stefan-schweiger/VdMot_Controller/hardware/case/vdmot_case_fitcheck.stl

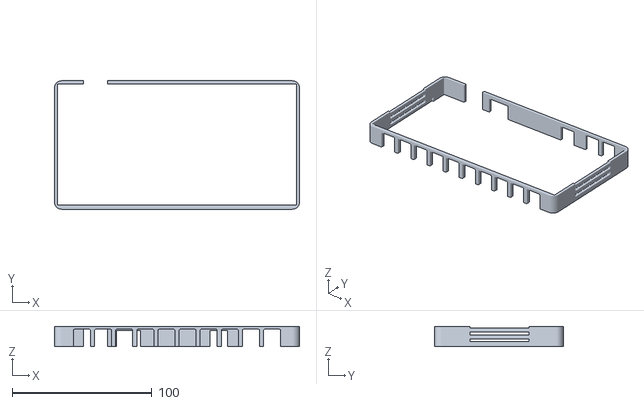
[picture p6: CAD file, 2026-10-22]
hardware/case/vdmot_case_fitcheck.stl
175.4 x 92.0 x 14.5
