stefan-schweiger/VdMot_Controller/hardware/case/vdmot_case_lid.stl

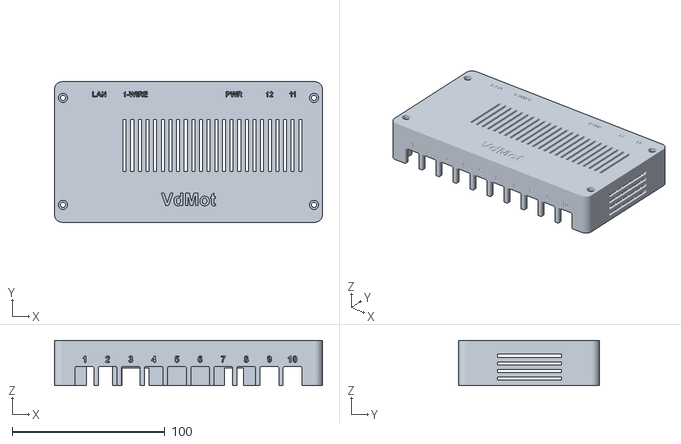
[picture p7: CAD file, 2026-10-22]
hardware/case/vdmot_case_lid.stl
175.4 x 92.0 x 29.5
