stefan-schweiger/VdMot_Controller/hardware/case/vdmot_case.step

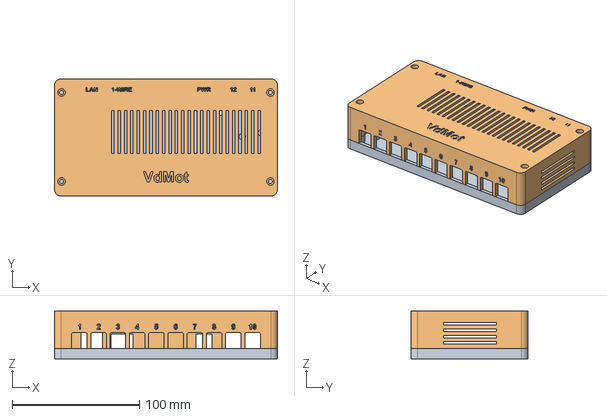
[picture p8: CAD file, 2026-10-22]
hardware/case/vdmot_case.step
175.4 x 92.0 x 37.6 mm
