stefan-schweiger/VdMot_Controller/hardware/case/vdmot_case_base.stl

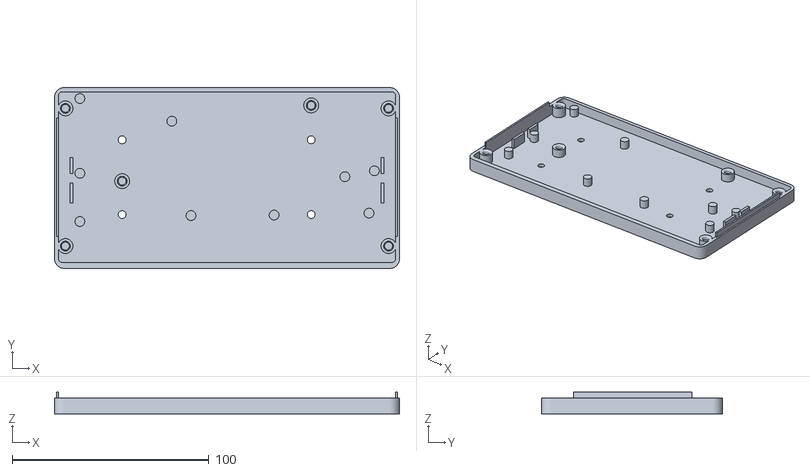
[picture p9: CAD file, 2026-10-22]
hardware/case/vdmot_case_base.stl
175.4 x 92.0 x 11.1
