stefan-schweiger/VdMot_Controller/software_esp32/src/main.cpp

/**HEADER*******************************************************************
  project : VdMot Controller

  author : SurfGargano, Lenti84

  Comments:

  Version :

  Modifcations :


***************************************************************************
*
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
  Copyright (C) 2021 Lenti84  https://github.com/Lenti84/VdMot_Controller

*END************************************************************************/


#include "globals.h"

#include "VdmConfig.h"
#include "VdmSystem.h"
#include "VdmNet.h"
#include "VdmTask.h"
#include "stm32.h"
#include "esp_task_wdt.h"
#include "esp_err.h"
#include "Messenger.h"
#include "VdmTask.h"
#include "RtcRam.h"
#include "PanicRecord.h"
#include "stmApp.h"

uint32_t * StackPtrAtStart;
uint32_t * StackPtrEnd;
UBaseType_t watermarkStart;
uint32_t stackSize;



void setup(void) {
  disableCore0WDT();
  disableCore1WDT();
  disableLoopWDT(); 

  UART_DBG.begin(115200);

  uint32_t* SpStart = NULL;
  StackPtrAtStart = (uint32_t *)&SpStart;
  watermarkStart =  uxTaskGetStackHighWaterMark(NULL);
  StackPtrEnd = StackPtrAtStart - watermarkStart;
  stackSize = StackPtrAtStart - StackPtrEnd;

  #ifdef EnvDevelop
    UART_DBG.println("VdMot_Controller");
    UART_DBG.printf("\r\n\r\nAddress of Stackpointer near start is:  %p \r\n",  (uint32_t *)StackPtrAtStart);
    UART_DBG.printf("End of Stack is near: %p \r\n",  (uint32_t *)StackPtrEnd);
    UART_DBG.printf("Free Stack near start is:  %d \r\n",  (uint32_t)StackPtrAtStart - (uint32_t)StackPtrEnd);
    UART_DBG.printf("Free Prefs entries  %d \r\n",  VdmConfig.prefs.freeEntries());
    UART_DBG.printf("Config space  %d bytes (max 20k) \r\n",  sizeof(VdmConfig.configFlash));
    UART_DBG.println("readingCnt read at Start "+String(readingCnt));
  #endif
  readingCnt = 123;

  UART_DBG.println("readingCnt read "+String(readingCnt));
  Stm32.STM32ota_setup();
  esp_reset_reason_t rr=esp_reset_reason();
  VdmSystem.panicInfo=takePanicRecord();
  if (VdmSystem.panicInfo.length()>0) UART_DBG.println("Crash before this start: "+VdmSystem.panicInfo);
  // a restart for new network settings or an ESP32 update keeps the STM32 running, so the valves keep
  // their positions and learned strokes, the ESP32 takes over its targets (StmApp.app_setup)
  // every other start resets the STM32 as before (except power on, it starts with the ESP32): a crash
  // or watchdog of the ESP32 may have left it in an unknown state, and "Reboot" restarts everything
  StmApp.keptRunning=(rr==ESP_RST_SW) && (keepStmRunning==KEEP_STM_RUNNING);
  keepStmRunning=0;
  if ((rr!=ESP_RST_POWERON) && !StmApp.keptRunning) {
    Stm32.ResetSTM32(false);
  }
  #ifdef EnvDevelop
    UART_DBG.println("Start Config");
  #endif
  // init config, read from flash, init network
  VdmSystem.stackSize = stackSize;
  VdmConfig.init();
  VdmConfig.checkToResetCfg();
  VdmNet.init();
  VdmTask.init();
  VdmSystem.getFSDirectory(); 
}

void loop(void) {
  taskManager.runLoop(); 
}
