stefan-schweiger/VdMot_Controller/software_esp32/include/VdmConfig.h

/**HEADER*******************************************************************
  project : VdMot Controller

  author : SurfGargano, Lenti84

  Comments:

  Version :

  Modifcations :


***************************************************************************
*
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
  Copyright (C) 2021 Lenti84  https://github.com/Lenti84/VdMot_Controller

*END************************************************************************/



#pragma once

#include "globals.h"
#include <Preferences.h>
#include <ArduinoJson.h>

#define pinSetFactoryCfg  2

enum protType  {protTypeNone=0,protTypeMqtt=1,protTypeMqttHA=2};

#define allowHeatingCooling 0
#define allowHeating 1
#define allowCooling 2

enum numFormat {numFormatIntl=0,numFormatGer=1};

typedef struct {
  uint8_t eth_wifi;
  bool dhcpEnabled;
  uint32_t staticIp;
  uint32_t mask;
  uint32_t gateway;
  uint32_t dnsIp;          
  char ssid[65];
  char pwd[65];
  char userName[65];
  char userPwd[65];
  char timeServer[65];
  long timeOffset;
  int daylightOffset; 
  uint8_t syslogLevel;
  uint32_t syslogIp;
  uint32_t syslogPort;
} VDM_NETWORK_CONFIG;

typedef struct {
  char tz[50];
  char tzCode[50];
} VDM_SYSTEM_TIME_ZONE_CONFIG;


typedef struct {
  uint8_t celsiusFahrenheit;
  char stationName[21];
} VDM_SYSTEM_CONFIG;

typedef struct  {
  uint8_t publishSeparate : 1 ;
  uint8_t publishAllTemps : 1;
  uint8_t publishPathAsRoot : 1 ;
  uint8_t publishUpTime : 1;
  uint8_t publishOnChange : 1;
  uint8_t publishRetained : 1;
  uint8_t publishPlainText : 1;
  uint8_t publishDiag : 1;
} VDM_PROTOCOL_CONFIG_FLAGS;

typedef struct  {
  uint8_t timeoutTSActive : 1 ;
  uint8_t timeoutDSActive : 1 ;
  uint8_t numFormat : 1 ;
} VDM_PROTOCOL_MQTT_CONFIG_FLAGS;


typedef struct  {
  VDM_PROTOCOL_MQTT_CONFIG_FLAGS flags;
  uint32_t timeOut;
  uint8_t toPos;
} VDM_PROTOCOL_MQTT_CONFIG;


typedef struct {
  uint8_t  dataProtocol; // 0 = no protocol , 1 = mqtt, 2 = mqtt HA
  uint32_t brokerIp;
  uint16_t brokerPort;
  uint32_t brokerInterval;
  uint32_t publishInterval;
  char userName[65];
  char userPwd[65];
  VDM_PROTOCOL_CONFIG_FLAGS protocolFlags;
  uint16_t keepAliveTime;
  uint32_t minBrokerDelay;
  VDM_PROTOCOL_MQTT_CONFIG mqttConfig;
} VDM_PROTOCOL_CONFIG;



// names of valves and sensors, they are part of the MQTT topics (10 characters until 1a222a0)
#define NAME_LEN                    30

typedef struct {
  char  name[NAME_LEN+1];
  bool active;
} VDM_VALVE_CONFIG;

typedef struct {
  VDM_VALVE_CONFIG valveConfig[ACTUATOR_COUNT];
  uint8_t dayOfCalib;
  uint8_t hourOfCalib;
} VDM_VALVES_CONFIG;

typedef struct  {
  uint8_t active : 1 ;
  uint8_t allow : 3;
  uint8_t windowInstalled : 1;
} VDM_VALVE_CONTROL_CONFIG_FLAGS;


typedef struct {
  VDM_VALVE_CONTROL_CONFIG_FLAGS controlFlags;
  uint8_t link;
  uint8_t valueSource;
  uint8_t targetSource;
  uint16_t xp;
  int8_t offset;
  uint16_t ti;
  uint16_t ts;
  float ki;
  uint8_t scheme;
  uint8_t startActiveZone;                // not used any more (the valve range does it), kept for the stored layout
  uint8_t endActiveZone;
} VDM_VALVE_CONTROL_CONFIG;

typedef struct {
  float tTarget;
} VDM_VALVE_CONTROL_INIT;

typedef struct {
  float alpha;
  float beta;
  float deadband;
} VDM_VALVE_CONTROL1_CONFIG;

typedef struct {
  VDM_VALVE_CONTROL_CONFIG valveControlConfig[ACTUATOR_COUNT];
  uint8_t heatControl;
  uint8_t parkingPosition;
} VDM_VALVES_CONTROL_CONFIG;

typedef struct {
  VDM_VALVE_CONTROL1_CONFIG valveControl1Config[ACTUATOR_COUNT];
} VDM_VALVES_CONTROL1_CONFIG;

typedef struct {
  VDM_VALVE_CONTROL_INIT valveControlInit[ACTUATOR_COUNT];
} VDM_VALVES_CONTROL_INIT;

// valve range, every target is mapped to it, each array stored with its own nvs key so the layout
// of the other valve control blobs stays unchanged
typedef struct {
  uint8_t rangeFrom[ACTUATOR_COUNT];      // smallest opening in % when the valve is open, 0..99, default 0
  uint8_t rangeTo[ACTUATOR_COUNT];        // opening in % for a target of 100 % (hydraulic balancing), 1..100, default 100
  uint8_t rangeCanClose[ACTUATOR_COUNT];  // 1: the valve can close (scaled: at 0 %, direct: below from), 0: it stays at rangeFrom, default 1
  uint8_t rangeMode[ACTUATOR_COUNT];      // rangeScaled (default) or rangeDirect
} VDM_VALVES_RANGE_CONFIG;

// scaled: the target 1..100 % is spread over from..to; direct: the target is the opening, cut at from and to
#define rangeScaled                 0
#define rangeDirect                 1
// direct with "can close": closes below from minus this, opens again at from
#define RANGE_HYSTERESIS            5

// what a valve does while its window is open and how long its controller ignores the room temperature after
// the window closed (minutes), with the values for all zones; stored with its own nvs key
typedef struct {
  uint8_t mode[ACTUATOR_COUNT];           // windowModeClose (default) or windowModeKeep
  uint8_t hold[ACTUATOR_COUNT];           // 0 = continue at once (default)
  uint8_t defaultMode;
  uint8_t defaultHold;
} VDM_VALVES_WINDOW_CONFIG;

// close: the valve goes to .../window/target (default 0 %); keep: it stays where it is
#define windowModeClose             0
#define windowModeKeep              1

// controller settings a zone takes from the settings for all zones unless it sets them itself,
// bit n of VDM_VALVES_CONTROL_SHARED.own is setting n, the names are the json keys (ctrlFieldNames)
enum {
  ctrlFieldValueSource, ctrlFieldTargetSource, ctrlFieldInitTarget, ctrlFieldXp, ctrlFieldTi, ctrlFieldWindow, ctrlFieldAllow,
  ctrlFieldTs, ctrlFieldDeadband, ctrlFieldOffset, ctrlFieldScheme, ctrlFieldKi, ctrlFieldWindowMode, ctrlFieldWindowHold,
  CTRL_FIELD_COUNT
};
extern const char* const ctrlFieldNames[CTRL_FIELD_COUNT];

typedef struct {
  VDM_VALVE_CONTROL_CONFIG control;       // active and link are not used
  float tTarget;
  float deadband;
} VDM_VALVE_CONTROL_DEFAULTS;

// stored with their own nvs keys, so the layout of the other valve control blobs stays unchanged
typedef struct {
  VDM_VALVE_CONTROL_DEFAULTS defaults;    // the settings for all zones
  uint16_t own[ACTUATOR_COUNT];           // the settings each zone sets itself
} VDM_VALVES_CONTROL_SHARED;


typedef struct {
  char name[NAME_LEN+1];
  bool active;
  int offset;
  char ID[25];
} VDM_TEMP_CONFIG;

typedef struct {
  VDM_TEMP_CONFIG tempConfig[TEMP_SENSORS_COUNT];
} VDM_TEMPS_CONFIG;

typedef struct {
  char name[NAME_LEN+1];
  bool active;
  float offset;
  float factor;
  char unit[9];
  char ID[25];
} VDM_VOLT_CONFIG;

typedef struct {
  uint8_t avType;
  uint16_t noOfAv;
} VDM_VOLT_AV_CONFIG;

typedef struct {
  VDM_VOLT_CONFIG voltConfig[VOLT_SENSORS_COUNT];
  VDM_VOLT_AV_CONFIG voltAVConfig[VOLT_SENSORS_COUNT];
} VDM_VOLTS_CONFIG;

// stored layout with names of 10 characters (until 1a222a0): taken over once at the start, and still written
// with shortened names, so an older firmware finds its settings
#define NAME_LEN_V1                 10

typedef struct {
  char name[NAME_LEN_V1+1];
  bool active;
} VDM_VALVE_CONFIG_V1;

typedef struct {
  char name[NAME_LEN_V1+1];
  bool active;
  int offset;
  char ID[25];
} VDM_TEMP_CONFIG_V1;

typedef struct {
  char name[NAME_LEN_V1+1];
  bool active;
  float offset;
  float factor;
  char unit[9];
  char ID[25];
} VDM_VOLT_CONFIG_V1;

typedef struct {
  VDM_VOLT_CONFIG_V1 voltConfig[VOLT_SENSORS_COUNT];
  VDM_VOLT_AV_CONFIG voltAVConfig[VOLT_SENSORS_COUNT];
} VDM_VOLTS_CONFIG_V1;

typedef struct  {
  uint8_t pushOver : 1 ;
  uint8_t email : 1 ;
} VDM_MSG_ACTIVE_CONFIG_FLAGS;

typedef struct  {
  uint8_t valveFailed : 1 ;
  uint8_t notDetect : 1;
  uint8_t mqttTimeOut : 1;
  uint8_t reset : 1;
  uint8_t ds18Failed : 1;
  uint8_t tValueFailed : 1;
  uint8_t valveBlocked : 1;
} VDM_MSG_REASON_CONFIG_FLAGS;

typedef struct  {
  VDM_MSG_REASON_CONFIG_FLAGS reasonFlags;
  uint16_t mqttTimeOutTime;
} VDM_MSG_REASON_CONFIG;

typedef struct {
  // pushover
  char userToken[31];
  char appToken[31];
  char title[31];
} VDM_MSG_PUSHOVER_CONFIG;

typedef struct {
  // email
  char user[65];
  char pwd[65];
  char host[65]; 
  uint16_t port;
  char recipient[65];
  char title[31];
} VDM_MSG_EMAIL_CONFIG;

typedef struct {
  VDM_MSG_ACTIVE_CONFIG_FLAGS activeFlags;
  VDM_MSG_REASON_CONFIG reason;
  VDM_MSG_PUSHOVER_CONFIG pushover;
  VDM_MSG_EMAIL_CONFIG email;
} VDM_MSG_CONFIG;

typedef struct 
{
  VDM_NETWORK_CONFIG netConfig;
  VDM_PROTOCOL_CONFIG protConfig;
  VDM_VALVES_CONFIG valvesConfig;
  VDM_TEMPS_CONFIG tempsConfig;
  VDM_VOLTS_CONFIG voltsConfig;
  VDM_SYSTEM_CONFIG systemConfig;
  VDM_VALVES_CONTROL_CONFIG valvesControlConfig;
  VDM_SYSTEM_TIME_ZONE_CONFIG timeZoneConfig;
  VDM_MSG_CONFIG messengerConfig;
  VDM_VALVES_CONTROL_INIT valvesControlInit;
  VDM_VALVES_CONTROL1_CONFIG valvesControl1Config;
  VDM_VALVES_RANGE_CONFIG valvesRangeConfig;
  VDM_VALVES_CONTROL_SHARED valvesControlShared;
  VDM_VALVES_WINDOW_CONFIG valvesWindowConfig;
} CONFIG_FLASH;

// settings as applied, a save applies only what has changed
typedef struct {
  VDM_NETWORK_CONFIG netConfig;
  VDM_PROTOCOL_CONFIG protConfig;
  VDM_SYSTEM_CONFIG systemConfig;
  VDM_SYSTEM_TIME_ZONE_CONFIG timeZoneConfig;
  VDM_VALVES_CONFIG valvesConfig;
} APPLIED_CONFIG;

typedef struct {
  time_t lastCalib; 
} MISC_VALUES;

typedef struct {
  uint8_t heatControl;
  uint8_t parkPosition; 
} HEATCFG_VALUES;

#define nvsNetCfg                   "netCfg"
#define nvsNetEthwifi               "ethwifi"
#define nvsNetDhcp                  "dhcp"
#define nvsNetStaticIp              "staticIp"
#define nvsNetMask                  "mask"
#define nvsNetGW                    "gw"
#define nvsNetDnsIp                 "dnsIp"       
#define nvsNetSsid                  "ssid"
#define nvsNetPwd                   "pwd"
#define nvsNetUserName              "userName"
#define nvsNetUserPwd               "userPwd"
#define nvsNetTimeServer            "timeServer"
#define nvsNetTimeOffset            "timeOffset"
#define nvsNetDayLightOffset        "dstOffset"
#define nvsNetSysLogEnable          "syslogEnable"
#define nvsNetSysLogIp              "sysLogIp"
#define nvsNetSysLogPort            "sysLogPort"

#define nvsTZCfg                    "tZCfg"
#define nvsTZ                       "tZ"
#define nvsTZCode                   "tZCode"

#define nvsProtCfg                  "protCfg"
#define nvsProtDataProt             "dataProt"
#define nvsProtBrokerIp             "brokerIp"
#define nvsProtBrokerPort           "brokerPort"
#define nvsProtBrokerInterval       "brokerInterval"
#define nvsProtPublishInterval      "publishInterval"
#define nvsProtBrokerUser           "brokerUser"
#define nvsProtBrokerPwd            "brokerPwd"
#define nvsProtBrokerPublishFlags   "brokerPF"
#define nvsProtBrokerKeepAliveTime  "brokerKAT"
#define nvsProtBrokerMinBrokerDelay "brokerMD"
#define nvsProtBrokerMQTTFlags      "brokerMQF"
#define nvsProtBrokerMQTTTimeOut    "brokerMQTO"
#define nvsProtBrokerMQTTToPos      "brokerMQToPos"

#define nvsValvesCfg                "valvesCfg"
#define nvsValvesControlCfg         "valvesCtrlCfg"
#define nvsValves                   "valves"
#define nvsValves2                  "valves2"       // with names of NAME_LEN characters
#define nvsValvesControl            "valvesCtrl"
#define nvsValvesControl1           "valvesCtrl1"
#define nvsValvesRangeFrom          "valvesCtrl2"   // held the minimum opening before, same meaning with "can close"
#define nvsValvesRangeTo            "valvesCtrl3"   // held the maximum opening before, same meaning
#define nvsValvesRangeCanClose      "valvesCtrl4"
#define nvsValvesControlDefaults    "valvesCtrl5"   // controller settings for all zones
#define nvsValvesControlOwn         "valvesCtrl6"   // the controller settings each zone sets itself
#define nvsValvesRangeMode          "valvesCtrl7"
#define nvsValvesWindow             "valvesCtrl8"
#define nvsValvesControlHeatControl "vCtrlHeat"
#define nvsValvesControlParkPos     "vCtrlParkPos"
#define nvsValvesControlInit        "vCtrlInit"

#define nvsTempsCfg                 "tempsCfg"
#define nvsTemps                    "temps"
#define nvsTemps2                   "temps2"

#define nvsVoltsCfg                 "voltsCfg"
#define nvsVolts                    "volts"
#define nvsVolts2                   "volts2"

#define nvsDayOfCalib               "dayOfCalib"
#define nvsHourOfCalib              "hourOfCalib"
#define nvsMovCalib                 "movCalib"

#define nvsMotorCfg                 "motorCfg"
#define nvsMotorMinC                "motorMinC"
#define nvsMotorMaxC                "motorMaxC"

#define nvsSystemCfg                "sysCfg"
#define nvsSystemCelsiusFahrenheit  "CF"
#define nvsSystemStationName        "stName"

#define nvsMsgCfg                   "msgCfg"
#define nvsMsgCfgFlags              "msgFlags"
#define nvsMsgCfgReason             "msgReas"
#define nvsMsgCfgMqttTimeout        "msgMQTO"
#define nvsMsgCfgPOAppToken         "POAppTk"
#define nvsMsgCfgPOUserToken        "POUserTk"
#define nvsMsgCfgPOTitle            "POTitle"

#define nvsMsgCfgEmailUser          "EUser"
#define nvsMsgCfgEmailPwd           "EPwd"
#define nvsMsgCfgEMailHost          "EHost"
#define nvsMsgCfgEmailPort          "EPort"
#define nvsMsgCfgEmailRecipient     "ERep"
#define nvsMsgCfgEmailTitle         "ETitle"

#define nvsMisc                     "Misc"
#define nvsMiscLastCalib            "MiscLC"

class CVdmConfig
{
public:
  CVdmConfig();
  void init();
  void setDefault();
  void clearConfig();
  void readConfig();
  void writeConfig(bool reboot=false);
  void saveConfig(bool restart);
  bool networkChanged();
  void resetConfig (bool reboot=false);
  void restoreConfig (bool reboot=false);
  void writeValvesControlConfig(bool reboot=false, bool restartTask=true);
  void writeSysLogValues();
  void postNetCfg (JsonObject doc);
  void postSysLogCfg (JsonObject doc);
  void postProtCfg (JsonObject doc);
  void postValvesCfg (JsonObject doc);
  void postValvesControlCfg (JsonObject doc);
  void postTempsCfg (JsonObject doc);
  void postVoltsCfg (JsonObject doc);
  void postSysCfg (JsonObject doc);
  void postMessengerCfg (JsonObject doc);
  String handleAuth (JsonObject doc);
  uint32_t doc2IPAddress(String id);
  void checkToResetCfg();
  void writeMiscValues();
  // controller settings for all zones, valve -1 = the settings for all zones
  double getCtrlField(int8_t valve, uint8_t field);
  void setCtrlField(int8_t valve, uint8_t field, double value);
  void deriveCtrlDefaults();
  void applyCtrlDefaults();
  uint16_t parseCtrlOwn(const char* names);
  String ctrlOwnNames(uint16_t own);

  Preferences prefs;

  CONFIG_FLASH configFlash;

  MISC_VALUES miscValues;
  HEATCFG_VALUES heatValues;
private:
  void applyConfig();
  void rememberApplied();
  VDM_NETWORK_CONFIG startNetConfig;    // the network is only set up at the start
  APPLIED_CONFIG appliedConfig;
};

extern CVdmConfig VdmConfig;
