stefan-schweiger/VdMot_Controller/software_esp32/src/VdmConfig.cpp

/**HEADER*******************************************************************
  project : VdMot Controller

  author : SurfGargano, Lenti84

  Comments:

  Version :

  Modifcations :


***************************************************************************
*
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
  Copyright (C) 2021 Lenti84  https://github.com/Lenti84/VdMot_Controller

*END************************************************************************/


#include <stdint.h>
#include "VdmConfig.h"
#include "VdmTask.h"
#include "web.h"
#include "Services.h"
#include "stmApp.h"
#include "PIControl.h"
#include "VdmNet.h"

CVdmConfig VdmConfig;

// copies a json string into a fixed size char array, the result is always null terminated
// values which are not a string (missing, null, numbers) are ignored
template <typename T>
static void copyJsonString(char* dest, size_t size, const T& value)
{
  const char* s = value.template as<const char*>();
  if (s != nullptr) strlcpy(dest, s, size);
}


CVdmConfig::CVdmConfig()
{
  
}

void CVdmConfig::init()
{
  setDefault();
  readConfig();
  startNetConfig=configFlash.netConfig;
  rememberApplied();
}

void CVdmConfig::resetConfig (bool reboot)
{  
  clearConfig(); 
  writeConfig();
  writeValvesControlConfig();
  if (reboot) Services.restartSystem(false);
}

void CVdmConfig::restoreConfig (bool reboot)
{  
  setDefault();
  writeConfig();
  writeValvesControlConfig();
  if (reboot) Services.restartSystem(false);
}

void CVdmConfig::setDefault()
{
  configFlash.netConfig.eth_wifi = 0;	      // 0 = auto (default)
  configFlash.netConfig.dhcpEnabled = 1;    // 0 = no DHCP, 1 = use DHCP
  configFlash.netConfig.staticIp = 0;
  configFlash.netConfig.mask = 0;
  configFlash.netConfig.gateway = 0;
  configFlash.netConfig.dnsIp = 0;
  memset (configFlash.netConfig.ssid,0,sizeof(configFlash.netConfig.ssid));
  memset (configFlash.netConfig.pwd,0,sizeof(configFlash.netConfig.pwd));
  memset (configFlash.netConfig.userName,0,sizeof(configFlash.netConfig.userName));
  memset (configFlash.netConfig.userPwd,0,sizeof(configFlash.netConfig.userPwd));
  memset (configFlash.timeZoneConfig.tz,0,sizeof(configFlash.timeZoneConfig.tz));
  memset (configFlash.timeZoneConfig.tzCode,0,sizeof(configFlash.timeZoneConfig.tzCode));
  clearConfig();
}

void CVdmConfig::clearConfig()
{ 
  configFlash.protConfig.dataProtocol = 0;
  configFlash.protConfig.brokerIp = 0;
  configFlash.protConfig.brokerPort = 0;
  configFlash.protConfig.brokerInterval = 1000;
  configFlash.protConfig.publishInterval = 10;
  configFlash.protConfig.minBrokerDelay = 5;
  memset (configFlash.protConfig.userName,0,sizeof(configFlash.protConfig.userName));
  memset (configFlash.protConfig.userPwd,0,sizeof(configFlash.protConfig.userPwd));
  configFlash.protConfig.protocolFlags.publishSeparate = false;
  configFlash.protConfig.protocolFlags.publishAllTemps = false;
  configFlash.protConfig.protocolFlags.publishPathAsRoot = false;
  configFlash.protConfig.protocolFlags.publishUpTime = false;
  configFlash.protConfig.protocolFlags.publishOnChange = false;
  configFlash.protConfig.protocolFlags.publishRetained = false;
  configFlash.protConfig.protocolFlags.publishPlainText = false;
  configFlash.protConfig.protocolFlags.publishDiag = false;
  configFlash.protConfig.keepAliveTime = 60;
  configFlash.protConfig.mqttConfig.flags.timeoutTSActive = false;
  configFlash.protConfig.mqttConfig.flags.timeoutDSActive = false;
  configFlash.protConfig.mqttConfig.timeOut = 120;
  configFlash.protConfig.mqttConfig.toPos = 10;
  
  for (uint8_t i=0; i<ACTUATOR_COUNT; i++) {
    configFlash.valvesConfig.valveConfig[i].active = false;
    memset (configFlash.valvesConfig.valveConfig[i].name,0,sizeof(configFlash.valvesConfig.valveConfig[i].name));
  }

  for (uint8_t i=0; i<ACTUATOR_COUNT; i++) {
    configFlash.valvesControlConfig.valveControlConfig[i].controlFlags.active = false;
    configFlash.valvesControlConfig.valveControlConfig[i].controlFlags.allow = allowHeatingCooling;
    configFlash.valvesControlConfig.valveControlConfig[i].controlFlags.windowInstalled = false;
    configFlash.valvesControlConfig.valveControlConfig[i].xp=20;
    configFlash.valvesControlConfig.valveControlConfig[i].link=0;
    configFlash.valvesControlConfig.valveControlConfig[i].offset=0;
    configFlash.valvesControlConfig.valveControlConfig[i].targetSource=0;
    configFlash.valvesControlConfig.valveControlConfig[i].valueSource=0;
    configFlash.valvesControlConfig.valveControlConfig[i].ti=3600;
    configFlash.valvesControlConfig.valveControlConfig[i].ts=900;
    configFlash.valvesControlConfig.valveControlConfig[i].scheme=0;
    configFlash.valvesControlConfig.valveControlConfig[i].ki=0.01;
    configFlash.valvesControlConfig.valveControlConfig[i].startActiveZone=0;
    configFlash.valvesControlConfig.valveControlConfig[i].endActiveZone=100;
    configFlash.valvesControlInit.valveControlInit[i].tTarget=20;
    configFlash.valvesControl1Config.valveControl1Config[i].deadband=0.0;
    configFlash.valvesRangeConfig.rangeFrom[i]=0;
    configFlash.valvesRangeConfig.rangeTo[i]=100;
    configFlash.valvesRangeConfig.rangeCanClose[i]=1;
    configFlash.valvesRangeConfig.rangeMode[i]=rangeScaled;
    configFlash.valvesWindowConfig.mode[i]=windowModeClose;
    configFlash.valvesWindowConfig.hold[i]=0;
  }
  configFlash.valvesWindowConfig.defaultMode=windowModeClose;
  configFlash.valvesWindowConfig.defaultHold=0;
  configFlash.valvesControlConfig.heatControl=0;
  configFlash.valvesControlConfig.parkingPosition=10;
  deriveCtrlDefaults();
 
  for (uint8_t i=0; i<TEMP_SENSORS_COUNT; i++) {
    configFlash.tempsConfig.tempConfig[i].active = false;
    configFlash.tempsConfig.tempConfig[i].offset = 0;
    memset (configFlash.tempsConfig.tempConfig[i].name,0,sizeof(configFlash.tempsConfig.tempConfig[i].name));
    memset (configFlash.tempsConfig.tempConfig[i].ID,0,sizeof(configFlash.tempsConfig.tempConfig[i].ID));
  }
  configFlash.systemConfig.celsiusFahrenheit=0;

  for (uint8_t i=0; i<VOLT_SENSORS_COUNT; i++) {
    configFlash.voltsConfig.voltConfig[i].active = false;
    configFlash.voltsConfig.voltConfig[i].offset = 0;
    configFlash.voltsConfig.voltConfig[i].factor = 1.0;
    memset (configFlash.voltsConfig.voltConfig[i].unit,0,sizeof(configFlash.voltsConfig.voltConfig[i].unit));
    memset (configFlash.voltsConfig.voltConfig[i].name,0,sizeof(configFlash.voltsConfig.voltConfig[i].name));
    memset (configFlash.voltsConfig.voltConfig[i].ID,0,sizeof(configFlash.voltsConfig.voltConfig[i].ID));
  }
  memset (configFlash.voltsConfig.voltAVConfig,0,sizeof(configFlash.voltsConfig.voltAVConfig));

  memset (configFlash.systemConfig.stationName,0,sizeof(configFlash.systemConfig.stationName));
  strncpy(configFlash.systemConfig.stationName,DEVICE_HOSTNAME,sizeof(configFlash.systemConfig.stationName));

  configFlash.valvesConfig.dayOfCalib=9;
  configFlash.valvesConfig.hourOfCalib=0;
  memset (configFlash.netConfig.timeServer,0,sizeof(configFlash.netConfig.timeServer));
  strncpy(configFlash.netConfig.timeServer,"pool.ntp.org",sizeof(configFlash.netConfig.timeServer));
  strncpy(configFlash.timeZoneConfig.tz,"Europe/Berlin",sizeof(configFlash.timeZoneConfig.tz));
  strncpy(configFlash.timeZoneConfig.tzCode,"CET-1CEST,M3.5.0,M10.5.0/3",sizeof(configFlash.timeZoneConfig.tzCode));

  configFlash.netConfig.syslogLevel=0;
  configFlash.netConfig.syslogIp=0;
  configFlash.netConfig.syslogPort=0; 

  configFlash.messengerConfig.activeFlags.pushOver=0;
  configFlash.messengerConfig.reason.reasonFlags.mqttTimeOut=0;
  configFlash.messengerConfig.reason.reasonFlags.notDetect=0;
  configFlash.messengerConfig.reason.reasonFlags.reset=0;
  configFlash.messengerConfig.reason.reasonFlags.valveFailed=0;
  configFlash.messengerConfig.reason.reasonFlags.ds18Failed=0;
  configFlash.messengerConfig.reason.reasonFlags.tValueFailed=0;
  configFlash.messengerConfig.reason.reasonFlags.valveBlocked=0;
  configFlash.messengerConfig.reason.mqttTimeOutTime=10;
  memset(configFlash.messengerConfig.pushover.title,0,sizeof(configFlash.messengerConfig.pushover.title));
  memset(configFlash.messengerConfig.pushover.appToken,0,sizeof(configFlash.messengerConfig.pushover.appToken));
  memset(configFlash.messengerConfig.pushover.userToken,0,sizeof(configFlash.messengerConfig.pushover.userToken));
  configFlash.messengerConfig.activeFlags.email=0;
  memset(&configFlash.messengerConfig.email,0,sizeof(configFlash.messengerConfig.email));

  miscValues.lastCalib=0;

}

// a name of the old layout (maybe without terminating zero) and back, shortened
static void nameFromV1(char *dst, size_t size, const char *src)
{
  memset(dst, 0, size);
  strncpy(dst, src, std::min(size-1, (size_t) NAME_LEN_V1));
}

static void nameToV1(char *dst, const char *src)
{
  memset(dst, 0, NAME_LEN_V1+1);
  strncpy(dst, src, NAME_LEN_V1);
}

void CVdmConfig::readConfig()
{
  if (prefs.begin(nvsSystemCfg,false)) {
    configFlash.systemConfig.celsiusFahrenheit=prefs.getUChar(nvsSystemCelsiusFahrenheit);
    if (prefs.isKey(nvsSystemStationName))
      prefs.getString(nvsSystemStationName,(char*) configFlash.systemConfig.stationName,sizeof(configFlash.systemConfig.stationName));
    prefs.end();
  }

  if (prefs.begin(nvsNetCfg,false)) {
    configFlash.netConfig.eth_wifi=prefs.getUChar(nvsNetEthwifi);
    configFlash.netConfig.dhcpEnabled=prefs.getUChar(nvsNetDhcp,1);
    configFlash.netConfig.staticIp=prefs.getULong(nvsNetStaticIp);
    configFlash.netConfig.mask=prefs.getULong(nvsNetMask);
    configFlash.netConfig.gateway=prefs.getULong(nvsNetGW);
    configFlash.netConfig.dnsIp=prefs.getULong(nvsNetDnsIp); 
    if (prefs.isKey(nvsNetSsid))
      prefs.getString(nvsNetSsid,(char*) configFlash.netConfig.ssid,sizeof(configFlash.netConfig.ssid));
    if (prefs.isKey(nvsNetPwd))
      prefs.getString(nvsNetPwd,(char*) configFlash.netConfig.pwd,sizeof(configFlash.netConfig.pwd));
    if (prefs.isKey(nvsNetUserName))
      prefs.getString(nvsNetUserName,(char*) configFlash.netConfig.userName,sizeof(configFlash.netConfig.userName));
    if (prefs.isKey(nvsNetUserPwd))
      prefs.getString(nvsNetUserPwd,(char*) configFlash.netConfig.userPwd,sizeof(configFlash.netConfig.userPwd));
    if (prefs.isKey(nvsNetTimeServer))
      prefs.getString(nvsNetTimeServer,(char*) configFlash.netConfig.timeServer,sizeof(configFlash.netConfig.timeServer));
   
    configFlash.netConfig.syslogLevel=prefs.getUChar(nvsNetSysLogEnable);
    configFlash.netConfig.syslogIp=prefs.getULong(nvsNetSysLogIp);
    configFlash.netConfig.syslogPort=prefs.getUShort(nvsNetSysLogPort);
    prefs.end();
  }
  if (prefs.begin(nvsProtCfg,false)) {
    configFlash.protConfig.dataProtocol = prefs.getUChar(nvsProtDataProt);
    configFlash.protConfig.brokerIp = prefs.getULong(nvsProtBrokerIp);
    configFlash.protConfig.brokerPort = prefs.getUShort(nvsProtBrokerPort);
    configFlash.protConfig.brokerInterval = prefs.getULong(nvsProtBrokerInterval,1000);
    configFlash.protConfig.publishInterval = prefs.getULong(nvsProtPublishInterval,10);
    if (prefs.isKey(nvsProtBrokerUser))
      prefs.getString(nvsProtBrokerUser,(char*) configFlash.protConfig.userName,sizeof(configFlash.protConfig.userName));
    if (prefs.isKey(nvsProtBrokerPwd))
      prefs.getString(nvsProtBrokerPwd,(char*) configFlash.protConfig.userPwd,sizeof(configFlash.protConfig.userPwd));
    uint8_t a=prefs.getUChar(nvsProtBrokerPublishFlags,7);
    configFlash.protConfig.protocolFlags =  *(VDM_PROTOCOL_CONFIG_FLAGS *)&a;
    configFlash.protConfig.keepAliveTime = prefs.getUShort(nvsProtBrokerKeepAliveTime,60);
    configFlash.protConfig.minBrokerDelay = prefs.getUShort(nvsProtBrokerMinBrokerDelay,5);
    a=prefs.getUChar(nvsProtBrokerMQTTFlags,0);
    configFlash.protConfig.mqttConfig.flags = *(VDM_PROTOCOL_MQTT_CONFIG_FLAGS *)&a;
    configFlash.protConfig.mqttConfig.timeOut =prefs.getULong(nvsProtBrokerMQTTTimeOut,120);
    configFlash.protConfig.mqttConfig.toPos=prefs.getUChar(nvsProtBrokerMQTTToPos,10);
    prefs.end();
  }

  if (prefs.begin(nvsValvesCfg,false)) {
    // names had 10 characters until 1a222a0, without the new key the old layout is taken over
    if (prefs.isKey(nvsValves2) && (prefs.getBytesLength(nvsValves2)==sizeof(configFlash.valvesConfig.valveConfig))) {
      prefs.getBytes(nvsValves2, (void *) configFlash.valvesConfig.valveConfig, sizeof(configFlash.valvesConfig.valveConfig));
    } else if (prefs.isKey(nvsValves) && (prefs.getBytesLength(nvsValves)==sizeof(VDM_VALVE_CONFIG_V1)*ACTUATOR_COUNT)) {
      VDM_VALVE_CONFIG_V1 old[ACTUATOR_COUNT];
      prefs.getBytes(nvsValves, (void *) old, sizeof(old));
      for (uint8_t i=0; i<ACTUATOR_COUNT; i++) {
        nameFromV1(configFlash.valvesConfig.valveConfig[i].name, sizeof(configFlash.valvesConfig.valveConfig[i].name), old[i].name);
        configFlash.valvesConfig.valveConfig[i].active=old[i].active;
      }
    }
    configFlash.valvesConfig.dayOfCalib=prefs.getUChar(nvsDayOfCalib,9);
    configFlash.valvesConfig.hourOfCalib=prefs.getUChar(nvsHourOfCalib); 
    prefs.end();
  }

  if (prefs.begin(nvsValvesControlCfg,false)) {
    if (prefs.isKey(nvsValvesControl)) {
      prefs.getBytes(nvsValvesControl, (void *) configFlash.valvesControlConfig.valveControlConfig, sizeof(configFlash.valvesControlConfig.valveControlConfig));
      configFlash.valvesControlConfig.heatControl=prefs.getUChar (nvsValvesControlHeatControl,0);
      configFlash.valvesControlConfig.parkingPosition=prefs.getUChar (nvsValvesControlParkPos,10);
      heatValues.heatControl=configFlash.valvesControlConfig.heatControl;
      heatValues.parkPosition=configFlash.valvesControlConfig.parkingPosition;
    }
    if (prefs.isKey(nvsValvesControl1)) {
      prefs.getBytes(nvsValvesControl1, (void *) configFlash.valvesControl1Config.valveControl1Config, sizeof(configFlash.valvesControl1Config.valveControl1Config));
    }
    if (prefs.isKey(nvsValvesControlInit)) {
      prefs.getBytes(nvsValvesControlInit, (void *) configFlash.valvesControlInit.valveControlInit, sizeof(configFlash.valvesControlInit.valveControlInit));
    }
    if (prefs.isKey(nvsValvesRangeFrom)) {
      prefs.getBytes(nvsValvesRangeFrom, (void *) configFlash.valvesRangeConfig.rangeFrom, sizeof(configFlash.valvesRangeConfig.rangeFrom));
    }
    if (prefs.isKey(nvsValvesRangeTo)) {
      prefs.getBytes(nvsValvesRangeTo, (void *) configFlash.valvesRangeConfig.rangeTo, sizeof(configFlash.valvesRangeConfig.rangeTo));
    }
    if (prefs.isKey(nvsValvesRangeCanClose)) {
      prefs.getBytes(nvsValvesRangeCanClose, (void *) configFlash.valvesRangeConfig.rangeCanClose, sizeof(configFlash.valvesRangeConfig.rangeCanClose));
    }
    if (prefs.isKey(nvsValvesRangeMode)) {
      prefs.getBytes(nvsValvesRangeMode, (void *) configFlash.valvesRangeConfig.rangeMode, sizeof(configFlash.valvesRangeConfig.rangeMode));
    }
    // invalid ranges fall back to the defaults
    for (uint8_t i=0; i<ACTUATOR_COUNT; i++) {
      uint8_t from=configFlash.valvesRangeConfig.rangeFrom[i];
      uint8_t to=configFlash.valvesRangeConfig.rangeTo[i];
      if ((from>99) || (to==0) || (to>100) || (from>=to)) {
        configFlash.valvesRangeConfig.rangeFrom[i]=0;
        configFlash.valvesRangeConfig.rangeTo[i]=100;
      }
      if (configFlash.valvesRangeConfig.rangeCanClose[i]>1) configFlash.valvesRangeConfig.rangeCanClose[i]=1;
      if (configFlash.valvesRangeConfig.rangeMode[i]>rangeDirect) configFlash.valvesRangeConfig.rangeMode[i]=rangeScaled;
    }
    if (prefs.isKey(nvsValvesWindow) && (prefs.getBytesLength(nvsValvesWindow)==sizeof(configFlash.valvesWindowConfig))) {
      prefs.getBytes(nvsValvesWindow, (void *) &configFlash.valvesWindowConfig, sizeof(configFlash.valvesWindowConfig));
      for (uint8_t i=0; i<ACTUATOR_COUNT; i++) {
        if (configFlash.valvesWindowConfig.mode[i]>windowModeKeep) configFlash.valvesWindowConfig.mode[i]=windowModeClose;
      }
      if (configFlash.valvesWindowConfig.defaultMode>windowModeKeep) configFlash.valvesWindowConfig.defaultMode=windowModeClose;
    }
    // controller settings for all zones, worked out from the zones when they were never saved
    if (prefs.isKey(nvsValvesControlDefaults) && prefs.isKey(nvsValvesControlOwn) &&
        (prefs.getBytesLength(nvsValvesControlDefaults)==sizeof(configFlash.valvesControlShared.defaults)) &&
        (prefs.getBytesLength(nvsValvesControlOwn)==sizeof(configFlash.valvesControlShared.own))) {
      prefs.getBytes(nvsValvesControlDefaults, (void *) &configFlash.valvesControlShared.defaults, sizeof(configFlash.valvesControlShared.defaults));
      prefs.getBytes(nvsValvesControlOwn, (void *) configFlash.valvesControlShared.own, sizeof(configFlash.valvesControlShared.own));
    } else deriveCtrlDefaults();
    applyCtrlDefaults();
    prefs.end();
  }
 


  if (prefs.begin(nvsTempsCfg,false)) {
    if (prefs.isKey(nvsTemps2) && (prefs.getBytesLength(nvsTemps2)==sizeof(configFlash.tempsConfig.tempConfig))) {
      prefs.getBytes(nvsTemps2, (void *) configFlash.tempsConfig.tempConfig, sizeof(configFlash.tempsConfig.tempConfig));
    } else if (prefs.isKey(nvsTemps) && (prefs.getBytesLength(nvsTemps)==sizeof(VDM_TEMP_CONFIG_V1)*TEMP_SENSORS_COUNT)) {
      VDM_TEMP_CONFIG_V1 *old = (VDM_TEMP_CONFIG_V1 *) malloc(sizeof(VDM_TEMP_CONFIG_V1)*TEMP_SENSORS_COUNT);
      if (old) {
        prefs.getBytes(nvsTemps, (void *) old, sizeof(VDM_TEMP_CONFIG_V1)*TEMP_SENSORS_COUNT);
        for (uint8_t i=0; i<TEMP_SENSORS_COUNT; i++) {
          VDM_TEMP_CONFIG &t = configFlash.tempsConfig.tempConfig[i];
          nameFromV1(t.name, sizeof(t.name), old[i].name);
          t.active=old[i].active;
          t.offset=old[i].offset;
          memcpy(t.ID, old[i].ID, sizeof(t.ID));
        }
        free(old);
      }
    }
    prefs.end();
  }

   if (prefs.begin(nvsVoltsCfg,false)) {
    if (prefs.isKey(nvsVolts2) && (prefs.getBytesLength(nvsVolts2)==sizeof(configFlash.voltsConfig))) {
      prefs.getBytes(nvsVolts2, (void *) &configFlash.voltsConfig, sizeof(configFlash.voltsConfig));
    } else if (prefs.isKey(nvsVolts) && (prefs.getBytesLength(nvsVolts)==sizeof(VDM_VOLTS_CONFIG_V1))) {
      VDM_VOLTS_CONFIG_V1 *old = (VDM_VOLTS_CONFIG_V1 *) malloc(sizeof(VDM_VOLTS_CONFIG_V1));
      if (old) {
        prefs.getBytes(nvsVolts, (void *) old, sizeof(VDM_VOLTS_CONFIG_V1));
        for (uint8_t i=0; i<VOLT_SENSORS_COUNT; i++) {
          VDM_VOLT_CONFIG &v = configFlash.voltsConfig.voltConfig[i];
          nameFromV1(v.name, sizeof(v.name), old->voltConfig[i].name);
          v.active=old->voltConfig[i].active;
          v.offset=old->voltConfig[i].offset;
          v.factor=old->voltConfig[i].factor;
          memcpy(v.unit, old->voltConfig[i].unit, sizeof(v.unit));
          memcpy(v.ID, old->voltConfig[i].ID, sizeof(v.ID));
          configFlash.voltsConfig.voltAVConfig[i]=old->voltAVConfig[i];
        }
        free(old);
      }
    }
    prefs.end();
  }

  if (prefs.begin(nvsTZCfg,false)) {
    if (prefs.isKey(nvsTZ))
      prefs.getString(nvsTZ,(char*) configFlash.timeZoneConfig.tz,sizeof(configFlash.timeZoneConfig.tz));
    if (prefs.isKey(nvsTZCode))
      prefs.getString(nvsTZCode,(char*) configFlash.timeZoneConfig.tzCode,sizeof(configFlash.timeZoneConfig.tzCode));
    prefs.end();
  }

  if (prefs.begin(nvsMsgCfg,false)) {
    uint8_t a=prefs.getUChar(nvsMsgCfgFlags,0);
    configFlash.messengerConfig.activeFlags =  *(VDM_MSG_ACTIVE_CONFIG_FLAGS *)&a;
    a=prefs.getUChar(nvsMsgCfgReason,0);
    configFlash.messengerConfig.reason.reasonFlags =  *(VDM_MSG_REASON_CONFIG_FLAGS *)&a;
    if (prefs.isKey(nvsMsgCfgMqttTimeout))
      configFlash.messengerConfig.reason.mqttTimeOutTime =prefs.getShort(nvsMsgCfgMqttTimeout,10);
    
    if (prefs.isKey(nvsMsgCfgPOAppToken))
      prefs.getString(nvsMsgCfgPOAppToken,(char*) configFlash.messengerConfig.pushover.appToken,sizeof(configFlash.messengerConfig.pushover.appToken));
    if (prefs.isKey(nvsMsgCfgPOUserToken))
      prefs.getString(nvsMsgCfgPOUserToken,(char*) configFlash.messengerConfig.pushover.userToken,sizeof(configFlash.messengerConfig.pushover.userToken));
    if (prefs.isKey(nvsMsgCfgPOTitle))
      prefs.getString(nvsMsgCfgPOTitle,(char*) configFlash.messengerConfig.pushover.title,sizeof(configFlash.messengerConfig.pushover.title));  
    
    if (prefs.isKey(nvsMsgCfgEmailUser))
      prefs.getString(nvsMsgCfgEmailUser,(char*) configFlash.messengerConfig.email.user,sizeof(configFlash.messengerConfig.email.user));
    if (prefs.isKey(nvsMsgCfgEmailPwd))
      prefs.getString(nvsMsgCfgEmailPwd,(char*) configFlash.messengerConfig.email.pwd,sizeof(configFlash.messengerConfig.email.pwd));
    if (prefs.isKey(nvsMsgCfgEMailHost))
      prefs.getString(nvsMsgCfgEMailHost,(char*) configFlash.messengerConfig.email.host,sizeof(configFlash.messengerConfig.email.host));
    configFlash.messengerConfig.email.port = prefs.getShort(nvsMsgCfgEmailPort,465);
    if (prefs.isKey(nvsMsgCfgEmailRecipient))
      prefs.getString(nvsMsgCfgEmailRecipient,(char*) configFlash.messengerConfig.email.recipient,sizeof(configFlash.messengerConfig.email.recipient));
    if (prefs.isKey(nvsMsgCfgEmailTitle))
      prefs.getString(nvsMsgCfgEmailTitle,(char*) configFlash.messengerConfig.email.title,sizeof(configFlash.messengerConfig.email.title));
    prefs.end();
  }

  if (prefs.begin(nvsMisc,false)) {
    if (prefs.isKey(nvsMiscLastCalib))
      miscValues.lastCalib=prefs.getLong(nvsMiscLastCalib,0);
    prefs.end();
  }
  
  for (uint8_t picIdx=0; picIdx<ACTUATOR_COUNT; picIdx++) { 
    PiControl[picIdx].target=VdmConfig.configFlash.valvesControlInit.valveControlInit[picIdx].tTarget;
  }

}

void CVdmConfig::writeConfig(bool reboot)
{
  prefs.begin(nvsSystemCfg,false);
  prefs.clear();
  prefs.putUChar(nvsSystemCelsiusFahrenheit,configFlash.systemConfig.celsiusFahrenheit);
  prefs.putString(nvsSystemStationName,configFlash.systemConfig.stationName);
  prefs.end();
 
  prefs.begin(nvsNetCfg,false);
  prefs.clear();
  prefs.putUChar(nvsNetEthwifi,configFlash.netConfig.eth_wifi);
  prefs.putUChar(nvsNetDhcp,configFlash.netConfig.dhcpEnabled);
  prefs.putULong(nvsNetStaticIp,configFlash.netConfig.staticIp);
  prefs.putULong(nvsNetMask,configFlash.netConfig.mask);
  prefs.putULong(nvsNetGW,configFlash.netConfig.gateway);
  prefs.putULong(nvsNetDnsIp,configFlash.netConfig.dnsIp); 
  prefs.putString(nvsNetSsid,configFlash.netConfig.ssid);
  prefs.putString(nvsNetPwd,configFlash.netConfig.pwd);
  prefs.putString(nvsNetUserName,configFlash.netConfig.userName);
  prefs.putString(nvsNetUserPwd,configFlash.netConfig.userPwd);
  prefs.putString(nvsNetTimeServer,configFlash.netConfig.timeServer);
  prefs.putUChar(nvsNetSysLogEnable,configFlash.netConfig.syslogLevel);
  prefs.putULong(nvsNetSysLogIp,configFlash.netConfig.syslogIp);
  prefs.putUShort(nvsNetSysLogPort,configFlash.netConfig.syslogPort);
  prefs.end();

  prefs.begin(nvsProtCfg,false);
  prefs.clear();
  prefs.putUChar(nvsProtDataProt,configFlash.protConfig.dataProtocol);
  if (configFlash.protConfig.dataProtocol>=protTypeMqtt) {
    prefs.putULong(nvsProtBrokerIp,configFlash.protConfig.brokerIp);
    prefs.putUShort(nvsProtBrokerPort,configFlash.protConfig.brokerPort);
    prefs.putULong(nvsProtBrokerInterval,configFlash.protConfig.brokerInterval);
    prefs.putULong(nvsProtPublishInterval,configFlash.protConfig.publishInterval);
    prefs.putString(nvsProtBrokerUser,configFlash.protConfig.userName);
    prefs.putString(nvsProtBrokerPwd,configFlash.protConfig.userPwd);
    uint8_t a = *(uint8_t *)&configFlash.protConfig.protocolFlags;
    prefs.putUChar(nvsProtBrokerPublishFlags,a);
    prefs.putUShort(nvsProtBrokerKeepAliveTime,configFlash.protConfig.keepAliveTime);
    prefs.putUShort(nvsProtBrokerMinBrokerDelay,configFlash.protConfig.minBrokerDelay);
    a = *(uint8_t *)&configFlash.protConfig.mqttConfig.flags;
    prefs.putUChar(nvsProtBrokerMQTTFlags,a);
    prefs.putULong(nvsProtBrokerMQTTTimeOut,configFlash.protConfig.mqttConfig.timeOut);
    prefs.putUChar(nvsProtBrokerMQTTToPos,configFlash.protConfig.mqttConfig.toPos);
  }
  prefs.end();
 
  prefs.begin(nvsValvesCfg,false);
  prefs.clear();
  prefs.putBytes(nvsValves2, (void *) configFlash.valvesConfig.valveConfig, sizeof(configFlash.valvesConfig.valveConfig));
  {
    VDM_VALVE_CONFIG_V1 old[ACTUATOR_COUNT];
    for (uint8_t i=0; i<ACTUATOR_COUNT; i++) {
      nameToV1(old[i].name, configFlash.valvesConfig.valveConfig[i].name);
      old[i].active=configFlash.valvesConfig.valveConfig[i].active;
    }
    prefs.putBytes(nvsValves, (void *) old, sizeof(old));
  }
  prefs.putUChar(nvsDayOfCalib,configFlash.valvesConfig.dayOfCalib);
  prefs.putUChar(nvsHourOfCalib,configFlash.valvesConfig.hourOfCalib);
  prefs.end();

  prefs.begin(nvsTempsCfg,false);
  prefs.clear();
  prefs.putBytes(nvsTemps2, (void *) configFlash.tempsConfig.tempConfig, sizeof(configFlash.tempsConfig.tempConfig));
  {
    VDM_TEMP_CONFIG_V1 *old = (VDM_TEMP_CONFIG_V1 *) calloc(TEMP_SENSORS_COUNT, sizeof(VDM_TEMP_CONFIG_V1));
    if (old) {
      for (uint8_t i=0; i<TEMP_SENSORS_COUNT; i++) {
        VDM_TEMP_CONFIG &t = configFlash.tempsConfig.tempConfig[i];
        nameToV1(old[i].name, t.name);
        old[i].active=t.active;
        old[i].offset=t.offset;
        memcpy(old[i].ID, t.ID, sizeof(old[i].ID));
      }
      prefs.putBytes(nvsTemps, (void *) old, sizeof(VDM_TEMP_CONFIG_V1)*TEMP_SENSORS_COUNT);
      free(old);
    }
  }
  prefs.end();

  prefs.begin(nvsVoltsCfg,false);
  prefs.clear();
  prefs.putBytes(nvsVolts2, (void *) &configFlash.voltsConfig, sizeof(configFlash.voltsConfig));
  {
    VDM_VOLTS_CONFIG_V1 *old = (VDM_VOLTS_CONFIG_V1 *) calloc(1, sizeof(VDM_VOLTS_CONFIG_V1));
    if (old) {
      for (uint8_t i=0; i<VOLT_SENSORS_COUNT; i++) {
        VDM_VOLT_CONFIG &v = configFlash.voltsConfig.voltConfig[i];
        nameToV1(old->voltConfig[i].name, v.name);
        old->voltConfig[i].active=v.active;
        old->voltConfig[i].offset=v.offset;
        old->voltConfig[i].factor=v.factor;
        memcpy(old->voltConfig[i].unit, v.unit, sizeof(old->voltConfig[i].unit));
        memcpy(old->voltConfig[i].ID, v.ID, sizeof(old->voltConfig[i].ID));
        old->voltAVConfig[i]=configFlash.voltsConfig.voltAVConfig[i];
      }
      prefs.putBytes(nvsVolts, (void *) old, sizeof(VDM_VOLTS_CONFIG_V1));
      free(old);
    }
  }
  prefs.end();
  
  prefs.begin(nvsTZCfg,false);
  prefs.clear();
  prefs.putString(nvsTZ,configFlash.timeZoneConfig.tz);
  prefs.putString(nvsTZCode,configFlash.timeZoneConfig.tzCode);
  prefs.end();

  prefs.begin(nvsMsgCfg,false);
  prefs.clear();
  uint8_t a = *(uint8_t *)&configFlash.messengerConfig.activeFlags;
  prefs.putUChar(nvsMsgCfgFlags,a);
  a = *(uint8_t *)&configFlash.messengerConfig.reason;
  prefs.putUChar(nvsMsgCfgReason,a);
  prefs.putShort(nvsMsgCfgMqttTimeout,configFlash.messengerConfig.reason.mqttTimeOutTime);
  prefs.putString(nvsMsgCfgPOAppToken,configFlash.messengerConfig.pushover.appToken);
  prefs.putString(nvsMsgCfgPOUserToken,configFlash.messengerConfig.pushover.userToken);
  prefs.putString(nvsMsgCfgPOTitle,configFlash.messengerConfig.pushover.title);

  prefs.putString(nvsMsgCfgEmailUser,configFlash.messengerConfig.email.user);
  prefs.putString(nvsMsgCfgEmailPwd,configFlash.messengerConfig.email.pwd);
  prefs.putString(nvsMsgCfgEMailHost,configFlash.messengerConfig.email.host);
  prefs.putShort(nvsMsgCfgEmailPort,configFlash.messengerConfig.email.port);
  prefs.putString(nvsMsgCfgEmailRecipient,configFlash.messengerConfig.email.recipient);
  prefs.putString(nvsMsgCfgEmailTitle,configFlash.messengerConfig.email.title);

  prefs.end();

  if (reboot) Services.restartSystem();
}

// the network settings need a restart, the other settings are applied by saveConfig()
bool CVdmConfig::networkChanged()
{
  const VDM_NETWORK_CONFIG& s=startNetConfig;
  const VDM_NETWORK_CONFIG& c=configFlash.netConfig;
  return ((s.eth_wifi!=c.eth_wifi) || (s.dhcpEnabled!=c.dhcpEnabled) || (s.staticIp!=c.staticIp) ||
          (s.mask!=c.mask) || (s.gateway!=c.gateway) || (s.dnsIp!=c.dnsIp) ||
          (strcmp(s.ssid,c.ssid)!=0) || (strcmp(s.pwd,c.pwd)!=0));
}

// writes the settings posted before, restarts for new network settings, otherwise applies them
// most settings are read where they are used, the time server, syslog and MQTT are set up again
void CVdmConfig::saveConfig(bool restart)
{
  writeConfig(false);
  if (restart) {
    Services.restartSystem(true, true);
    return;
  }
  applyConfig();
}

void CVdmConfig::applyConfig()
{
  const VDM_NETWORK_CONFIG& net=configFlash.netConfig;
  const VDM_NETWORK_CONFIG& appliedNet=appliedConfig.netConfig;

  if ((strcmp(net.timeServer,appliedNet.timeServer)!=0) ||
      (strcmp(configFlash.timeZoneConfig.tzCode,appliedConfig.timeZoneConfig.tzCode)!=0)) {
    VdmNet.setupNtp();
  }
  if ((net.syslogLevel!=appliedNet.syslogLevel) || (net.syslogIp!=appliedNet.syslogIp) ||
      (net.syslogPort!=appliedNet.syslogPort)) {
    VdmNet.syslogStarted=false;
    VdmNet.startSysLog();
  }
  // the topics, the client id (station name) and the subscriptions (valve names) are set when connecting
  if ((memcmp(&configFlash.protConfig,&appliedConfig.protConfig,sizeof(configFlash.protConfig))!=0) ||
      (strcmp(configFlash.systemConfig.stationName,appliedConfig.systemConfig.stationName)!=0) ||
      (memcmp(configFlash.valvesConfig.valveConfig,appliedConfig.valvesConfig.valveConfig,sizeof(configFlash.valvesConfig.valveConfig))!=0)) {
    VdmNet.restartBroker();
  }
  rememberApplied();
}

void CVdmConfig::rememberApplied()
{
  memcpy(&appliedConfig.netConfig,&configFlash.netConfig,sizeof(appliedConfig.netConfig));
  memcpy(&appliedConfig.protConfig,&configFlash.protConfig,sizeof(appliedConfig.protConfig));
  memcpy(&appliedConfig.systemConfig,&configFlash.systemConfig,sizeof(appliedConfig.systemConfig));
  memcpy(&appliedConfig.timeZoneConfig,&configFlash.timeZoneConfig,sizeof(appliedConfig.timeZoneConfig));
  memcpy(&appliedConfig.valvesConfig,&configFlash.valvesConfig,sizeof(appliedConfig.valvesConfig));
}

void CVdmConfig::writeMiscValues()
{
  prefs.begin(nvsMisc,false);
  prefs.putLong(nvsMiscLastCalib,miscValues.lastCalib);
  prefs.end();
}

void CVdmConfig::writeValvesControlConfig(bool reboot, bool restartTask)
{
  prefs.begin(nvsValvesControlCfg,false);
  prefs.clear();
  prefs.putBytes(nvsValvesControl, (void *) configFlash.valvesControlConfig.valveControlConfig, sizeof(configFlash.valvesControlConfig.valveControlConfig));
  prefs.putBytes(nvsValvesControl1, (void *) configFlash.valvesControl1Config.valveControl1Config, sizeof(configFlash.valvesControl1Config.valveControl1Config));
  prefs.putBytes(nvsValvesControlInit, (void *) configFlash.valvesControlInit.valveControlInit, sizeof(configFlash.valvesControlInit.valveControlInit));
  prefs.putBytes(nvsValvesRangeFrom, (void *) configFlash.valvesRangeConfig.rangeFrom, sizeof(configFlash.valvesRangeConfig.rangeFrom));
  prefs.putBytes(nvsValvesRangeTo, (void *) configFlash.valvesRangeConfig.rangeTo, sizeof(configFlash.valvesRangeConfig.rangeTo));
  prefs.putBytes(nvsValvesRangeCanClose, (void *) configFlash.valvesRangeConfig.rangeCanClose, sizeof(configFlash.valvesRangeConfig.rangeCanClose));
  prefs.putBytes(nvsValvesRangeMode, (void *) configFlash.valvesRangeConfig.rangeMode, sizeof(configFlash.valvesRangeConfig.rangeMode));
  prefs.putBytes(nvsValvesWindow, (void *) &configFlash.valvesWindowConfig, sizeof(configFlash.valvesWindowConfig));
  prefs.putBytes(nvsValvesControlDefaults, (void *) &configFlash.valvesControlShared.defaults, sizeof(configFlash.valvesControlShared.defaults));
  prefs.putBytes(nvsValvesControlOwn, (void *) configFlash.valvesControlShared.own, sizeof(configFlash.valvesControlShared.own));
  prefs.putUChar (nvsValvesControlHeatControl,configFlash.valvesControlConfig.heatControl);
  prefs.putUChar (nvsValvesControlParkPos,configFlash.valvesControlConfig.parkingPosition);
  prefs.end();
  if (VdmConfig.configFlash.netConfig.syslogLevel>=VISMODE_ATOMIC) {
    syslog.log(LOG_DEBUG, "pic: write control config, reboot = "+String(reboot)+" , restart = "+String(restartTask)+" , initiated = "+String(VdmTask.piTaskInitiated));
  }
  if (reboot) {
    Services.restartSystem();
  } else {
    if (VdmTask.piTaskInitiated) {
      if (restartTask) VdmTask.stopPIServices();
      VdmTask.startPIServices(restartTask);
    }
  }
}

void CVdmConfig::writeSysLogValues()
{
  prefs.begin(nvsNetCfg,false);
  prefs.putUChar(nvsNetSysLogEnable,configFlash.netConfig.syslogLevel);
  prefs.putULong(nvsNetSysLogIp,configFlash.netConfig.syslogIp);
  prefs.putUShort(nvsNetSysLogPort,configFlash.netConfig.syslogPort);
  prefs.end();
}

uint32_t CVdmConfig::doc2IPAddress(String id)
{
  IPAddress c1;
  bool b;
  b=c1.fromString(id) ; 
  if (b) return (uint32_t) c1; else return 0;
}

void CVdmConfig::postNetCfg (JsonObject doc)
{
  if (!doc["ethWifi"].isNull()) configFlash.netConfig.eth_wifi=doc["ethWifi"];
  if (!doc["dhcp"].isNull()) configFlash.netConfig.dhcpEnabled=doc["dhcp"];
  if (!doc["ip"].isNull()) configFlash.netConfig.staticIp=doc2IPAddress(doc["ip"]);
  if (!doc["mask"].isNull()) configFlash.netConfig.mask=doc2IPAddress(doc["mask"]);
  if (!doc["gw"].isNull()) configFlash.netConfig.gateway=doc2IPAddress(doc["gw"]);
  if (!doc["dns"].isNull()) configFlash.netConfig.dnsIp=doc2IPAddress(doc["dns"]);
  copyJsonString(configFlash.netConfig.ssid,sizeof(configFlash.netConfig.ssid),doc["ssid"]);
  copyJsonString(configFlash.netConfig.pwd,sizeof(configFlash.netConfig.pwd),doc["pwd"]);
  copyJsonString(configFlash.netConfig.userName,sizeof(configFlash.netConfig.userName),doc["userName"]);
  copyJsonString(configFlash.netConfig.userPwd,sizeof(configFlash.netConfig.userPwd),doc["userPwd"]);
  copyJsonString(configFlash.netConfig.timeServer,sizeof(configFlash.netConfig.timeServer),doc["timeServer"]);
  if (!doc["syslogLevel"].isNull()) configFlash.netConfig.syslogLevel=doc["syslogLevel"];
  if (!doc["syslogIp"].isNull()) configFlash.netConfig.syslogIp=doc2IPAddress(doc["syslogIp"]);
  if (!doc["syslogPort"].isNull()) configFlash.netConfig.syslogPort=doc["syslogPort"];
  copyJsonString(configFlash.timeZoneConfig.tz,sizeof(configFlash.timeZoneConfig.tz),doc["tz"]);
  copyJsonString(configFlash.timeZoneConfig.tzCode,sizeof(configFlash.timeZoneConfig.tzCode),doc["tzCode"]);
}

void CVdmConfig::postSysLogCfg (JsonObject doc)
{
  if (!doc["syslogLevel"].isNull()) configFlash.netConfig.syslogLevel=doc["syslogLevel"];
  if (!doc["syslogIp"].isNull()) configFlash.netConfig.syslogIp=doc2IPAddress(doc["syslogIp"]);
  if (!doc["syslogPort"].isNull()) configFlash.netConfig.syslogPort=doc["syslogPort"];
}

void CVdmConfig::postProtCfg (JsonObject doc)
{
  if (!doc["prot"].isNull()) configFlash.protConfig.dataProtocol = doc["prot"];
  if (!doc["ip"].isNull()) configFlash.protConfig.brokerIp = doc2IPAddress(doc["ip"]);
  if (!doc["port"].isNull()) configFlash.protConfig.brokerPort = doc["port"];
  if (!doc["interval"].isNull()) configFlash.protConfig.brokerInterval = doc["interval"];
  if (!doc["publish"].isNull()) configFlash.protConfig.publishInterval = doc["publish"];
  copyJsonString(configFlash.protConfig.userName,sizeof(configFlash.protConfig.userName),doc["user"]);
  copyJsonString(configFlash.protConfig.userPwd,sizeof(configFlash.protConfig.userPwd),doc["pwd"]);
  if (!doc["pubSeparate"].isNull()) configFlash.protConfig.protocolFlags.publishSeparate = doc["pubSeparate"];
  if (!doc["pubAllTemps"].isNull()) configFlash.protConfig.protocolFlags.publishAllTemps = doc["pubAllTemps"];
  if (!doc["pubPathAsRoot"].isNull()) configFlash.protConfig.protocolFlags.publishPathAsRoot = doc["pubPathAsRoot"];
  if (!doc["pubUpTime"].isNull()) configFlash.protConfig.protocolFlags.publishUpTime = doc["pubUpTime"];
  if (!doc["pubOnChange"].isNull()) configFlash.protConfig.protocolFlags.publishOnChange = doc["pubOnChange"];
  if (!doc["pubRetained"].isNull()) configFlash.protConfig.protocolFlags.publishRetained = doc["pubRetained"];
  if (!doc["pubPlainText"].isNull()) configFlash.protConfig.protocolFlags.publishPlainText = doc["pubPlainText"];
  if (!doc["pubDiag"].isNull()) configFlash.protConfig.protocolFlags.publishDiag = doc["pubDiag"];
  if (!doc["keepAliveTime"].isNull()) configFlash.protConfig.keepAliveTime = doc["keepAliveTime"];
  if (!doc["pubMinDelay"].isNull()) configFlash.protConfig.minBrokerDelay = doc["pubMinDelay"];
  if (!doc["mqttTOTSActive"].isNull()) configFlash.protConfig.mqttConfig.flags.timeoutTSActive = doc["mqttTOTSActive"];
  if (!doc["mqttTODSActive"].isNull()) configFlash.protConfig.mqttConfig.flags.timeoutDSActive = doc["mqttTODSActive"];
  if (!doc["mqttTO"].isNull()) configFlash.protConfig.mqttConfig.timeOut = doc["mqttTO"];
  if (!doc["mqttToPos"].isNull()) configFlash.protConfig.mqttConfig.toPos = doc["mqttToPos"];
  if (!doc["numFormat"].isNull()) configFlash.protConfig.mqttConfig.flags.numFormat = doc["numFormat"];
}

void CVdmConfig::postValvesCfg (JsonObject doc)
{
  uint8_t idx=0; 
  size_t size=doc["valves"].size();
  if (!doc["calib"]["dayOfCalib"].isNull()) configFlash.valvesConfig.dayOfCalib=doc["calib"]["dayOfCalib"];
  if (!doc["calib"]["hourOfCalib"].isNull()) configFlash.valvesConfig.hourOfCalib=doc["calib"]["hourOfCalib"];

  for (uint8_t i=0; i<size; i++) {
     if (!doc["valves"][i]["no"].isNull()) {
      idx=doc["valves"][i]["no"];
      idx--;
      if ((idx>=0) && (idx<12)) {
          copyJsonString(configFlash.valvesConfig.valveConfig[idx].name,sizeof(configFlash.valvesConfig.valveConfig[idx].name),doc["valves"][i]["name"]);
          if (!doc["valves"][i]["active"].isNull()) configFlash.valvesConfig.valveConfig[idx].active=doc["valves"][i]["active"];
          // tIdx is 1 based, 0 = no sensor assigned
          if (!doc["valves"][i]["tIdx1"].isNull()) {
            uint8_t tIdx=doc["valves"][i]["tIdx1"];
            if (tIdx<=TEMP_SENSORS_COUNT) {
              StmApp.actuators[idx].tIdx1=tIdx;
              StmApp.setTempIdxActive=true;
            }
          }
          if (!doc["valves"][i]["tIdx2"].isNull()) {
            uint8_t tIdx=doc["valves"][i]["tIdx2"];
            if (tIdx<=TEMP_SENSORS_COUNT) {
              StmApp.actuators[idx].tIdx2=tIdx;
              StmApp.setTempIdxActive=true;
            }
          }
      }
     }
  }    
  if (!doc["calib"]["cycles"].isNull()) {
    StmApp.learnAfterMovements=doc["calib"]["cycles"];
    StmApp.setLearnAfterMovements();
  }
  if (!doc["motor"]["lowC"].isNull()) {
    StmApp.motorChars.maxLowCurrent=doc["motor"]["lowC"];
    StmApp.setMotorCharsActive=true;
  }
  if (!doc["motor"]["highC"].isNull()) {
    StmApp.motorChars.maxHighCurrent=doc["motor"]["highC"];
    StmApp.setMotorCharsActive=true;
  }
  if (!doc["motor"]["startOnPower"].isNull()) {
    StmApp.motorChars.startOnPower=doc["motor"]["startOnPower"];
    StmApp.setMotorCharsActive=true;
  }
  if (!doc["motor"]["noOfMinCount"].isNull()) {
    StmApp.motorChars.noOfMinCount=doc["motor"]["noOfMinCount"];
    StmApp.setMotorCharsActive=true;
  }
  if (!doc["motor"]["maxCalReps"].isNull()) {
    StmApp.motorChars.maxCalReps=doc["motor"]["maxCalReps"];
    StmApp.setMotorCharsActive=true;
  }
  if (StmApp.setMotorCharsActive) {
    StmApp.setMotorChars();
    StmApp.setMotorCharsActive=false;
  }
  if (!doc["tempIdx"]["set"].isNull()) {
    uint8_t setTemp=doc["tempIdx"]["set"]; 
    if ((StmApp.setTempIdxActive) && (setTemp==1)) {
      StmApp.setTempIdx();
      //StmApp.matchSensors();
      //StmApp.matchSensorRequest = true;
      StmApp.setTempIdxActive=false;
    }
  }
}

const char* const ctrlFieldNames[CTRL_FIELD_COUNT] = {"vSource", "tSource", "inittTarget", "xp", "ti", "window", "allow",
  "ts", "deadband", "offset", "scheme", "ki", "windowMode", "windowHold"};

// two settings are the same when they differ less than the web page shows
static bool sameCtrlValue(double a, double b)
{
  return (fabs(a-b)<0.0005);
}

// a controller setting of a valve or, with valve -1, of the settings for all zones
double CVdmConfig::getCtrlField(int8_t valve, uint8_t field)
{
  VDM_VALVE_CONTROL_CONFIG &c = (valve<0) ? configFlash.valvesControlShared.defaults.control : configFlash.valvesControlConfig.valveControlConfig[valve];
  switch (field) {
    case ctrlFieldValueSource:  return (c.valueSource);
    case ctrlFieldTargetSource: return (c.targetSource);
    case ctrlFieldInitTarget:   return ((valve<0) ? configFlash.valvesControlShared.defaults.tTarget : configFlash.valvesControlInit.valveControlInit[valve].tTarget);
    case ctrlFieldXp:           return (c.xp);
    case ctrlFieldTi:           return (c.ti);
    case ctrlFieldWindow:       return (c.controlFlags.windowInstalled);
    case ctrlFieldAllow:        return (c.controlFlags.allow);
    case ctrlFieldTs:           return (c.ts);
    case ctrlFieldDeadband:     return ((valve<0) ? configFlash.valvesControlShared.defaults.deadband : configFlash.valvesControl1Config.valveControl1Config[valve].deadband);
    case ctrlFieldOffset:       return (c.offset);
    case ctrlFieldScheme:       return (c.scheme);
    case ctrlFieldKi:           return (c.ki);
    case ctrlFieldWindowMode:   return ((valve<0) ? configFlash.valvesWindowConfig.defaultMode : configFlash.valvesWindowConfig.mode[valve]);
    case ctrlFieldWindowHold:   return ((valve<0) ? configFlash.valvesWindowConfig.defaultHold : configFlash.valvesWindowConfig.hold[valve]);
  }
  return (0);
}

void CVdmConfig::setCtrlField(int8_t valve, uint8_t field, double value)
{
  VDM_VALVE_CONTROL_CONFIG &c = (valve<0) ? configFlash.valvesControlShared.defaults.control : configFlash.valvesControlConfig.valveControlConfig[valve];
  long n = lround(value);
  switch (field) {
    case ctrlFieldValueSource:  c.valueSource=n; break;
    case ctrlFieldTargetSource: c.targetSource=n; break;
    case ctrlFieldInitTarget:
      if (valve<0) configFlash.valvesControlShared.defaults.tTarget=value;
      else configFlash.valvesControlInit.valveControlInit[valve].tTarget=value;
      break;
    case ctrlFieldXp:           c.xp=n; break;
    case ctrlFieldTi:           c.ti=n; break;
    case ctrlFieldWindow:       c.controlFlags.windowInstalled=(n!=0) ? 1 : 0; break;
    case ctrlFieldAllow:        c.controlFlags.allow=n; break;
    case ctrlFieldTs:
      // a new sample time needs a restart of the controller task, like a posted one
      if ((valve>=0) && (c.ts!=(uint16_t) n)) VdmTask.restartPiTask=true;
      c.ts=n;
      break;
    case ctrlFieldDeadband:
      if (valve<0) configFlash.valvesControlShared.defaults.deadband=value;
      else configFlash.valvesControl1Config.valveControl1Config[valve].deadband=value;
      break;
    case ctrlFieldOffset:       c.offset=n; break;
    case ctrlFieldScheme:       c.scheme=n; break;
    case ctrlFieldKi:           c.ki=value; break;
    case ctrlFieldWindowMode:
      n = (n==windowModeKeep) ? windowModeKeep : windowModeClose;
      if (valve<0) configFlash.valvesWindowConfig.defaultMode=n; else configFlash.valvesWindowConfig.mode[valve]=n;
      break;
    case ctrlFieldWindowHold:
      n = (n<0) ? 0 : ((n>255) ? 255 : n);
      if (valve<0) configFlash.valvesWindowConfig.defaultHold=n; else configFlash.valvesWindowConfig.hold[valve]=n;
      break;
  }
}

// settings that were never saved: the settings for all zones are the most common ones of the zones with
// their own controller, a zone sets a value itself when it differs
void CVdmConfig::deriveCtrlDefaults()
{
  uint8_t zones[ACTUATOR_COUNT];
  uint8_t count=0;
  for (uint8_t i=0; i<ACTUATOR_COUNT; i++) {
    VDM_VALVE_CONTROL_CONFIG &c = configFlash.valvesControlConfig.valveControlConfig[i];
    if (c.controlFlags.active && (c.link==0)) zones[count++]=i;
  }
  if (count==0) zones[count++]=0;
  for (uint8_t f=0; f<CTRL_FIELD_COUNT; f++) {
    uint8_t best=zones[0];
    uint8_t bestCount=0;
    for (uint8_t a=0; a<count; a++) {
      uint8_t same=0;
      for (uint8_t b=0; b<count; b++) {
        if (sameCtrlValue(getCtrlField(zones[a], f), getCtrlField(zones[b], f))) same++;
      }
      if (same>bestCount) {
        best=zones[a];
        bestCount=same;
      }
    }
    setCtrlField(-1, f, getCtrlField(best, f));
  }
  configFlash.valvesControlShared.defaults.control.controlFlags.active=0;
  configFlash.valvesControlShared.defaults.control.link=0;
  for (uint8_t i=0; i<ACTUATOR_COUNT; i++) {
    uint16_t own=0;
    VDM_VALVE_CONTROL_CONFIG &c = configFlash.valvesControlConfig.valveControlConfig[i];
    if (c.controlFlags.active && (c.link==0)) {
      for (uint8_t f=0; f<CTRL_FIELD_COUNT; f++) {
        if (!sameCtrlValue(getCtrlField(i, f), getCtrlField(-1, f))) own |= (1<<f);
      }
      // ki is only used with static ki
      if (c.scheme!=1) own &= ~(1<<ctrlFieldKi);
    }
    configFlash.valvesControlShared.own[i]=own;
  }
}

// the settings a zone does not set itself are the settings for all zones
void CVdmConfig::applyCtrlDefaults()
{
  for (uint8_t i=0; i<ACTUATOR_COUNT; i++) {
    for (uint8_t f=0; f<CTRL_FIELD_COUNT; f++) {
      if (!(configFlash.valvesControlShared.own[i] & (1<<f))) setCtrlField(i, f, getCtrlField(-1, f));
    }
  }
}

// "xp,ti" to the bits of the settings
uint16_t CVdmConfig::parseCtrlOwn(const char* names)
{
  uint16_t own=0;
  if (names==nullptr) return (own);
  String list=String(names)+",";
  int start=0;
  int comma;
  while ((comma=list.indexOf(',', start))>=0) {
    String name=list.substring(start, comma);
    name.trim();
    for (uint8_t f=0; f<CTRL_FIELD_COUNT; f++) {
      if (name==ctrlFieldNames[f]) own |= (1<<f);
    }
    start=comma+1;
  }
  return (own);
}

String CVdmConfig::ctrlOwnNames(uint16_t own)
{
  String result="";
  for (uint8_t f=0; f<CTRL_FIELD_COUNT; f++) {
    if (own & (1<<f)) {
      if (result.length()>0) result+=",";
      result+=ctrlFieldNames[f];
    }
  }
  return (result);
}

void CVdmConfig::postValvesControlCfg (JsonObject doc)
{
  uint8_t idx=0;
  size_t size=doc["valves"].size();

  // the settings for all zones first, the valves of the same post refer to them
  if (doc["defaults"].is<JsonObject>()) {
    for (uint8_t f=0; f<CTRL_FIELD_COUNT; f++) {
      if (!doc["defaults"][ctrlFieldNames[f]].isNull()) setCtrlField(-1, f, doc["defaults"][ctrlFieldNames[f]].as<double>());
    }
  }

  if (size==0) {
      for (uint8_t i =0;i<ACTUATOR_COUNT;i++) {
        if (!doc["active"].isNull()) configFlash.valvesControlConfig.valveControlConfig[i].controlFlags.active=doc["active"];
        if (!doc["allow"].isNull()) configFlash.valvesControlConfig.valveControlConfig[i].controlFlags.allow=doc["allow"];
        if (!doc["window"].isNull()) configFlash.valvesControlConfig.valveControlConfig[i].controlFlags.windowInstalled=doc["window"];
        if (!doc["vSource"].isNull()) configFlash.valvesControlConfig.valveControlConfig[i].valueSource=doc["vSource"];
        if (!doc["tSource"].isNull()) configFlash.valvesControlConfig.valveControlConfig[i].targetSource=doc["tSource"];
        if (!doc["scheme"].isNull()) configFlash.valvesControlConfig.valveControlConfig[i].scheme=doc["scheme"];
        if (!doc["inittTarget"].isNull()) configFlash.valvesControlInit.valveControlInit[i].tTarget=doc["inittTarget"];
        if (!doc["deadband"].isNull()) configFlash.valvesControl1Config.valveControl1Config[i].deadband=doc["deadband"];
      }
      // a value for all valves is the setting for all zones too
      for (uint8_t f=0; f<CTRL_FIELD_COUNT; f++) {
        if (!doc[ctrlFieldNames[f]].isNull()) setCtrlField(-1, f, doc[ctrlFieldNames[f]].as<double>());
      }
  } else {
    for (uint8_t i=0; i<size; i++) {
      if (!doc["valves"][i]["no"].isNull()) {
        idx=doc["valves"][i]["no"];
        idx--;
        if ((idx>=0) && (idx<12)) {
          if (!doc["valves"][i]["active"].isNull()) configFlash.valvesControlConfig.valveControlConfig[idx].controlFlags.active=doc["valves"][i]["active"];
          if (!doc["valves"][i]["allow"].isNull()) configFlash.valvesControlConfig.valveControlConfig[idx].controlFlags.allow=doc["valves"][i]["allow"];
          if (!doc["valves"][i]["window"].isNull()) configFlash.valvesControlConfig.valveControlConfig[idx].controlFlags.windowInstalled=doc["valves"][i]["window"];
          if (!doc["valves"][i]["link"].isNull()) {
            // link is 1 based, 0 = not linked
            uint8_t link=doc["valves"][i]["link"];
            if (link<=ACTUATOR_COUNT) configFlash.valvesControlConfig.valveControlConfig[idx].link=link;
          }
          if (!doc["valves"][i]["vSource"].isNull()) configFlash.valvesControlConfig.valveControlConfig[idx].valueSource=doc["valves"][i]["vSource"];
          if (!doc["valves"][i]["tSource"].isNull()) configFlash.valvesControlConfig.valveControlConfig[idx].targetSource=doc["valves"][i]["tSource"];
          if (!doc["valves"][i]["xp"].isNull()) configFlash.valvesControlConfig.valveControlConfig[idx].xp=doc["valves"][i]["xp"];
          if (!doc["valves"][i]["offset"].isNull()) configFlash.valvesControlConfig.valveControlConfig[idx].offset=doc["valves"][i]["offset"];
          if (!doc["valves"][i]["ti"].isNull()) configFlash.valvesControlConfig.valveControlConfig[idx].ti=doc["valves"][i]["ti"];
          if (!doc["valves"][i]["ts"].isNull()) {
            uint16_t ts = doc["valves"][i]["ts"];
            if (configFlash.valvesControlConfig.valveControlConfig[idx].ts!=ts) VdmTask.restartPiTask=true;
            configFlash.valvesControlConfig.valveControlConfig[idx].ts=ts;
          }
          if (!doc["valves"][i]["ki"].isNull()) configFlash.valvesControlConfig.valveControlConfig[idx].ki=doc["valves"][i]["ki"];  
          if (!doc["valves"][i]["scheme"].isNull()) configFlash.valvesControlConfig.valveControlConfig[idx].scheme=doc["valves"][i]["scheme"];  
          if (!doc["valves"][i]["inittTarget"].isNull()) configFlash.valvesControlInit.valveControlInit[idx].tTarget=doc["valves"][i]["inittTarget"];  
          if (!doc["valves"][i]["deadband"].isNull()) configFlash.valvesControl1Config.valveControl1Config[idx].deadband=doc["valves"][i]["deadband"];
          // valve range: a missing value keeps the stored one, an invalid pair is ignored
          if (!doc["valves"][i]["rangeFrom"].isNull() || !doc["valves"][i]["rangeTo"].isNull()) {
            int from=doc["valves"][i]["rangeFrom"].isNull() ? configFlash.valvesRangeConfig.rangeFrom[idx] : doc["valves"][i]["rangeFrom"].as<int>();
            int to=doc["valves"][i]["rangeTo"].isNull() ? configFlash.valvesRangeConfig.rangeTo[idx] : doc["valves"][i]["rangeTo"].as<int>();
            if ((from>=0) && (from<=99) && (to>=1) && (to<=100) && (from<to)) {
              configFlash.valvesRangeConfig.rangeFrom[idx]=from;
              configFlash.valvesRangeConfig.rangeTo[idx]=to;
            }
          }
          if (!doc["valves"][i]["rangeClose"].isNull()) {
            configFlash.valvesRangeConfig.rangeCanClose[idx]=(doc["valves"][i]["rangeClose"].as<int>()!=0) ? 1 : 0;
          }
          if (!doc["valves"][i]["rangeMode"].isNull()) {
            configFlash.valvesRangeConfig.rangeMode[idx]=(doc["valves"][i]["rangeMode"].as<int>()==rangeDirect) ? rangeDirect : rangeScaled;
          }
          // what the valve does while the window is open, how long the temperature is ignored after closing
          if (!doc["valves"][i]["windowMode"].isNull()) setCtrlField(idx, ctrlFieldWindowMode, doc["valves"][i]["windowMode"].as<double>());
          if (!doc["valves"][i]["windowHold"].isNull()) setCtrlField(idx, ctrlFieldWindowHold, doc["valves"][i]["windowHold"].as<double>());
          // the settings the zone sets itself; clients without "own" set a value itself when it differs from the one for all zones
          if (!doc["valves"][i]["own"].isNull()) {
            configFlash.valvesControlShared.own[idx]=parseCtrlOwn(doc["valves"][i]["own"].as<const char*>());
          } else {
            for (uint8_t f=0; f<CTRL_FIELD_COUNT; f++) {
              if (!doc["valves"][i][ctrlFieldNames[f]].isNull() && !sameCtrlValue(getCtrlField(idx, f), getCtrlField(-1, f)))
                configFlash.valvesControlShared.own[idx] |= (1<<f);
            }
          }
        }
      }
    } 
  }
  applyCtrlDefaults();
  if (!doc["common"]["heatControl"].isNull()) {
    configFlash.valvesControlConfig.heatControl=doc["common"]["heatControl"];
    heatValues.heatControl=configFlash.valvesControlConfig.heatControl;
  } 
  if (!doc["common"]["parkPosition"].isNull()) {
    configFlash.valvesControlConfig.parkingPosition=doc["common"]["parkPosition"];
    heatValues.parkPosition=configFlash.valvesControlConfig.parkingPosition;
  } 
}

void CVdmConfig::postTempsCfg (JsonObject doc)
{
  uint8_t chunkStart=doc["chunkStart"];
  uint8_t chunkEnd=doc["chunkEnd"];
  uint8_t idx=0;

  // chunk indices are 1 based
  if (chunkStart<1) return;
  if (chunkEnd>TEMP_SENSORS_COUNT) chunkEnd=TEMP_SENSORS_COUNT;
  for (uint8_t i=chunkStart-1; i<chunkEnd; i++) {
    copyJsonString(configFlash.tempsConfig.tempConfig[i].name,sizeof(configFlash.tempsConfig.tempConfig[i].name),doc["temps"][idx]["name"]);
    copyJsonString(configFlash.tempsConfig.tempConfig[i].ID,sizeof(configFlash.tempsConfig.tempConfig[i].ID),doc["temps"][idx]["id"]);
    if (!doc["temps"][idx]["active"].isNull()) configFlash.tempsConfig.tempConfig[i].active=doc["temps"][idx]["active"];
    if (!doc["temps"][idx]["offset"].isNull()) configFlash.tempsConfig.tempConfig[i].offset=10*(doc["temps"][idx]["offset"].as<float>()) ;
    idx++;
  }
}

void CVdmConfig::postVoltsCfg (JsonObject doc)
{
  size_t size=doc["volts"].size();
  if (size>VOLT_SENSORS_COUNT) size=VOLT_SENSORS_COUNT;
  for (uint8_t i=0; i<size; i++) {
    copyJsonString(configFlash.voltsConfig.voltConfig[i].name,sizeof(configFlash.voltsConfig.voltConfig[i].name),doc["volts"][i]["name"]);
    copyJsonString(configFlash.voltsConfig.voltConfig[i].ID,sizeof(configFlash.voltsConfig.voltConfig[i].ID),doc["volts"][i]["id"]);
    if (!doc["volts"][i]["active"].isNull()) configFlash.voltsConfig.voltConfig[i].active=doc["volts"][i]["active"];
    if (!doc["volts"][i]["offset"].isNull()) configFlash.voltsConfig.voltConfig[i].offset=(doc["volts"][i]["offset"].as<float>()) ;
    if (!doc["volts"][i]["factor"].isNull()) configFlash.voltsConfig.voltConfig[i].factor=(doc["volts"][i]["factor"].as<float>()) ;
    copyJsonString(configFlash.voltsConfig.voltConfig[i].unit,sizeof(configFlash.voltsConfig.voltConfig[i].unit),doc["volts"][i]["unit"]);
  }
}


void CVdmConfig::postSysCfg (JsonObject doc)
{
  if (!doc["CF"].isNull()) configFlash.systemConfig.celsiusFahrenheit = doc["CF"];
  copyJsonString(configFlash.systemConfig.stationName,sizeof(configFlash.systemConfig.stationName),doc["station"]);
 
}

void CVdmConfig::postMessengerCfg (JsonObject doc)
{
  if (!doc["reason"]["valveFailed"].isNull()) configFlash.messengerConfig.reason.reasonFlags.valveFailed=doc["reason"]["valveFailed"];
  if (!doc["reason"]["notDetect"].isNull()) configFlash.messengerConfig.reason.reasonFlags.notDetect=doc["reason"]["notDetect"];
  if (!doc["reason"]["mqttTimeOut"].isNull()) configFlash.messengerConfig.reason.reasonFlags.mqttTimeOut=doc["reason"]["mqttTimeOut"];
  if (!doc["reason"]["mqttTimeOutTime"].isNull()) configFlash.messengerConfig.reason.mqttTimeOutTime=doc["reason"]["mqttTimeOutTime"];
  if (!doc["reason"]["reset"].isNull()) configFlash.messengerConfig.reason.reasonFlags.reset=doc["reason"]["reset"];
  if (!doc["reason"]["ds18Failed"].isNull()) configFlash.messengerConfig.reason.reasonFlags.ds18Failed=doc["reason"]["ds18Failed"];
  if (!doc["reason"]["tValueFailed"].isNull()) configFlash.messengerConfig.reason.reasonFlags.tValueFailed=doc["reason"]["tValueFailed"];
   if (!doc["reason"]["valveBlocked"].isNull()) configFlash.messengerConfig.reason.reasonFlags.valveBlocked=doc["reason"]["valveBlocked"];

  if (!doc["PO"]["active"].isNull()) configFlash.messengerConfig.activeFlags.pushOver=doc["PO"]["active"];
  copyJsonString(configFlash.messengerConfig.pushover.appToken,sizeof(configFlash.messengerConfig.pushover.appToken),doc["PO"]["appToken"]);
  copyJsonString(configFlash.messengerConfig.pushover.userToken,sizeof(configFlash.messengerConfig.pushover.userToken),doc["PO"]["userToken"]);
  copyJsonString(configFlash.messengerConfig.pushover.title,sizeof(configFlash.messengerConfig.pushover.title),doc["PO"]["title"]);
  
  if (!doc["Email"]["active"].isNull()) configFlash.messengerConfig.activeFlags.email=doc["Email"]["active"];
  copyJsonString(configFlash.messengerConfig.email.user,sizeof(configFlash.messengerConfig.email.user),doc["Email"]["user"]);
  copyJsonString(configFlash.messengerConfig.email.pwd,sizeof(configFlash.messengerConfig.email.pwd),doc["Email"]["pwd"]);
  copyJsonString(configFlash.messengerConfig.email.host,sizeof(configFlash.messengerConfig.email.host),doc["Email"]["host"]);
  if (!doc["Email"]["port"].isNull()) configFlash.messengerConfig.email.port=doc["Email"]["port"];
  copyJsonString(configFlash.messengerConfig.email.recipient,sizeof(configFlash.messengerConfig.email.recipient),doc["Email"]["recipient"]);
  copyJsonString(configFlash.messengerConfig.email.title,sizeof(configFlash.messengerConfig.email.title),doc["Email"]["title"]);
}

String CVdmConfig::handleAuth (JsonObject doc)
{
  bool userCheck=false;
  bool pwdCheck=false;
  uint8_t result=0;
  if ((strlen(configFlash.netConfig.userName)>0) && (strlen(configFlash.netConfig.userPwd)>0)) {
    if (!(doc["user"].isNull() || doc["pwd"].isNull())) {
      const char* du=doc["user"] | "";
      const char* dp=doc["pwd"] | "";
      userCheck=(strncmp (configFlash.netConfig.userName,du,sizeof(configFlash.netConfig.userName)))==0;
      pwdCheck=(strncmp (configFlash.netConfig.userPwd,dp,sizeof(configFlash.netConfig.userPwd)))==0;
    }
    if (userCheck) result+=1;  // userName compares
    if (pwdCheck) result+=2;  // pwdName compares
  } else result=3;
  return ("{\"auth\":"+String(result)+"}");
}



void CVdmConfig::checkToResetCfg() {
  pinMode(pinSetFactoryCfg, INPUT_PULLUP);
  if (digitalRead(pinSetFactoryCfg)==0) {  
    #ifdef EnvDevelop
      UART_DBG.println("Entry reset config");
    #endif
    delay(1000);
    if (digitalRead(pinSetFactoryCfg)==0) {
        #ifdef EnvDevelop
          UART_DBG.println("Reset config, remove shortcut");
        #endif
        while (digitalRead(pinSetFactoryCfg)==0) {
          delay(100);
        }
        #ifdef EnvDevelop
          UART_DBG.println("Reset config now");
        #endif
        VdmConfig.restoreConfig(true);
    }
  }
}
