stefan-schweiger/VdMot_Controller/software_esp32/src/PIControl.cpp

/**HEADER*******************************************************************
  project : VdMot Controller

  author : SurfGargano, Lenti84

  Comments:

  Version :

  Modifcations :


***************************************************************************
*
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
  Copyright (C) 2021 Lenti84  https://github.com/Lenti84/VdMot_Controller

*END************************************************************************/


#include "PIControl.h"
#include "time.h"
#include <cmath>
#include "globals.h"
#include "stmApp.h"
#include "VdmConfig.h"
#include "VdmNet.h"
#include <Syslog.h>
#include "RtcRam.h"


CPiControl PiControl[ACTUATOR_COUNT];

void CPiControl::savePiControl() {
  if (!isStarted()) return;
  piControlRtcs.piControlRtc[valveIndex].target=target;
  piControlRtcs.piControlRtc[valveIndex].value=value;
  piControlRtcs.piControlRtc[valveIndex].iProp=iProp;
  piControlRtcs.piControlRtc[valveIndex].esum=esum;
  strncpy(piControlRtcs.piControlRtc[valveIndex].pattern,RTC_RAM_PATTERN,sizeof(piControlRtcs.piControlRtc[valveIndex].pattern));
  piControlRtcs.piControlRtc[valveIndex].lastControlPosition=lastControlPosition;
}

void CPiControl::reloadPiControl() {
  if (!isStarted()) return;
  if (strncmp(piControlRtcs.piControlRtc[valveIndex].pattern,RTC_RAM_PATTERN,sizeof(RTC_RAM_PATTERN))==0) {
    target=piControlRtcs.piControlRtc[valveIndex].target;
    value=piControlRtcs.piControlRtc[valveIndex].value;
    iProp=piControlRtcs.piControlRtc[valveIndex].iProp;
    esum=piControlRtcs.piControlRtc[valveIndex].esum;
    lastControlPosition=piControlRtcs.piControlRtc[valveIndex].lastControlPosition;
    start=true;
    time(&ts);
    setValveAction(lastControlPosition);
  //  UART_DBG.println("Reload pi valve # "+String(valveIndex+1));
    if (VdmConfig.configFlash.netConfig.syslogLevel>=VISMODE_ATOMIC) {
      syslog.log(LOG_DEBUG, "pic: reload pi valve # "+String(valveIndex+1)+" ("+String(VdmConfig.configFlash.valvesConfig.valveConfig[valveIndex].name)+") tTarget = "+String(target)+" tValue = "+String(value)+" iProp = "+String(iProp)+" esum = "+String(esum)+" position = "+String(lastControlPosition));
    }
  } else  {
    if (VdmConfig.configFlash.netConfig.syslogLevel>=VISMODE_ATOMIC) {
      syslog.log(LOG_DEBUG, "pic: no reload pi valve # "+String(valveIndex+1)+" ("+String(VdmConfig.configFlash.valvesConfig.valveConfig[valveIndex].name)+")");
    }
   // UART_DBG.println("No reload pi valve # "+String(valveIndex+1));
    setValveAction(VdmConfig.configFlash.valvesControlInit.valveControlInit[valveIndex].tTarget);
  }
}

double CPiControl::getpProp(float e) {
   // p - proportion
   double p = kp * e + 50 + offset + dynOffset;
   if (p > 100.0) p = 100.0;
   if (p < 0.0) p = 0.0;  
   return p;
}

float CPiControl::piCtrl(float target,float value) {
  double p;
  double y;
  double e;
  double dt;
  time_t now;

  if ((xp==0) || (ti==0)) return (startValvePos);
  
  if (!start) {
    time(&ts);
    iProp=startValvePos-50;
    start=true;
    esum=0;
  }

  old_esum=esum;

  time(&now);
  double elapsed=difftime(now,ts);      // in sec
  time(&ts);
  // the clock jumps when sntp syncs after the start, use the configured sample time then
  uint16_t sampleTime=VdmConfig.configFlash.valvesControlConfig.valveControlConfig[valveIndex].ts;
  if ((elapsed<0) || (elapsed>2.0*sampleTime)) ta=sampleTime; else ta=elapsed;
 
  dt =  ((double)ta / (double)ti);

  if (windowControlState == windowCloseRestore) {
    ta = VdmConfig.configFlash.valvesControlConfig.valveControlConfig[valveIndex].ts;
    windowControlState = windowIdle;
  }
  
  if (VdmConfig.heatValues.heatControl==piControlOnHeating)
  {
    e=target-value;
  } else {
    e=value-target;
  } 

  switch (scheme) {
    default:
    case piControlDynamicKi : 
    {
      // p - proportion
      p = getpProp(e);
      // i - proportion
      iProp += dt * kp * e;
      // pi
      y = p + iProp;
      break;
    } 
    case piControlStaticKi : 
    {
      // p - proportion
      //p = getpProp(e);
      p = kp * e + 50 + offset + dynOffset;
      esum += e*dt;
      iProp = ki * esum;
      // pi
      y = p + iProp;
    break;
    }
  }

  if (VdmConfig.configFlash.netConfig.syslogLevel>=VISMODE_ATOMIC) {
    syslog.log(LOG_DEBUG, "pic: calc valve position : #"+String(valveIndex+1)+" ("+String(VdmConfig.configFlash.valvesConfig.valveConfig[valveIndex].name)+") tTarget = "+String(target)+" tValue = "+String(value)+" diff = "+String(e)+" iProp = "+String(iProp)+" kp = "+String(kp)+" esum = "+String(esum)+" p = "+String(p)+" y = "+String(y));
  }

  // the output stops (and the integral part with it) where the valve does not change any more
  double yMin, yMax;
  StmApp.controlLimits(valveIndex, yMin, yMax);
  if (y > yMax) {
    y = yMax;
    iProp = yMax - p;
    if (esum>old_esum) esum=old_esum;
  }
  if (y < yMin) {
    y = yMin;
    iProp = yMin - p;
    if (esum<old_esum) esum=old_esum;
  }

  if (VdmConfig.configFlash.netConfig.syslogLevel>=VISMODE_ATOMIC) {
    syslog.log(LOG_DEBUG, "pic: calc valve position corrected : #"+String(valveIndex+1)+" ("+String(VdmConfig.configFlash.valvesConfig.valveConfig[valveIndex].name)+") tTarget = "+String(target)+" tValue = "+String(value)+" diff = "+String(e)+" iProp = "+String(iProp)+" kp = "+String(kp)+" esum = "+String(esum)+" p = "+String(p)+" y = "+String(y));
  }

  return y;
}

void CPiControl::setWindowAction(uint8_t windowControl)
{
 if (!isStarted()) return;
 if (VdmConfig.configFlash.valvesControlConfig.valveControlConfig[valveIndex].controlFlags.windowInstalled && controlActive && 
    (VdmConfig.heatValues.heatControl==1 || VdmConfig.heatValues.heatControl==2))
 {
  windowState = windowControl;
  switch (windowControl) {
    case windowActionCloseRestore: {
      // after an open window the temperature is ignored a while longer, until the air of the room is warm again;
      // a repeated "close" neither starts nor extends that
      if ((windowControlState==windowOpenLock) && (VdmConfig.configFlash.valvesWindowConfig.hold[valveIndex]>0)) {
        windowControlState = windowHoldAfterClose;
        windowHoldStart = millis();
      } else if (windowControlState!=windowHoldAfterClose) windowControlState = windowCloseRestore;
      setValveAction(lastControlPosition);
      break;
    }
    case windowActionOpenLock: {
      windowControlState = windowOpenLock;
      setValveAction(windowPosition());
      break;
    }
  }
 } else {
  if (windowControlState == windowOpenLock) {
    windowControlState = windowCloseRestore;
    setValveAction(lastControlPosition);
  }
 }
}

// position while the window is open: the window target or where the controller had the valve
uint8_t CPiControl::windowPosition()
{
  return ((VdmConfig.configFlash.valvesWindowConfig.mode[valveIndex]==windowModeKeep) ? lastControlPosition : windowOpenTarget);
}

void CPiControl::setValveAction(uint8_t valvePosition) {
  if (!isStarted()) return;
  if (!(failed) && (VdmConfig.configFlash.valvesControlConfig.valveControlConfig[valveIndex].controlFlags.active && controlActive)) {
    StmApp.actuators[valveIndex].target_position=valvePosition;
    if (VdmConfig.configFlash.netConfig.syslogLevel>=VISMODE_ATOMIC) {
      syslog.log(LOG_DEBUG, "pic: setValveAction valve position has changed : "+String(VdmConfig.configFlash.valvesConfig.valveConfig[valveIndex].name)+"(#"+String(valveIndex+1)+") = "+String(valvePosition)+" Ttarget "+String(target)+" Tvalue "+String(value));
    }
    // check if there are links
    for (uint8_t i=0; i< ACTUATOR_COUNT; i++) {
      if (VdmConfig.configFlash.valvesControlConfig.valveControlConfig[i].controlFlags.active) {
        if (VdmConfig.configFlash.valvesControlConfig.valveControlConfig[i].link==(valveIndex+1)) {
          StmApp.actuators[i].target_position=valvePosition;
          if (VdmConfig.configFlash.netConfig.syslogLevel>=VISMODE_ATOMIC) {
            syslog.log(LOG_DEBUG, "pic:setValveAction link valve position has changed : "+String(VdmConfig.configFlash.valvesConfig.valveConfig[i].name)+"(#"+String(i+1)+") = "+String(valvePosition));
          }
        }
      }
    }
  }
}


CHECKACTION CPiControl::checkAction(uint8_t idx)
{
  if (!isStarted()) return(nothing);
  if (!controlActive) return(nothing);
  if (!VdmConfig.configFlash.valvesControlConfig.valveControlConfig[valveIndex].controlFlags.active)  return(nothing);
  if (failed) return(nothing);

  if (!VdmConfig.configFlash.valvesControlConfig.valveControlConfig[valveIndex].controlFlags.windowInstalled) {
    windowControlState = windowIdle;  
  }
  // while the window is open and the configured time after closing the controller ignores the room temperature
  if (windowControlState == windowOpenLock) {
    setPosition(windowPosition());
    return(nothing);
  }
  if (windowControlState == windowHoldAfterClose) {
    // counted from the last close (millis survives clock jumps and wraps), ends at once without heat control
    bool heating = (VdmConfig.heatValues.heatControl==piControlOnHeating) || (VdmConfig.heatValues.heatControl==piControlOnCooling);
    if (heating && (millis()-windowHoldStart < (uint32_t) VdmConfig.configFlash.valvesWindowConfig.hold[valveIndex]*60000UL)) {
      setPosition(lastControlPosition);
      return(nothing);
    }
    windowControlState = windowCloseRestore;
  }
  
  switch (VdmConfig.heatValues.heatControl)
  {
    case piControlManual:
      return(nothing);
    case piControlOnHeating:
      if ((VdmConfig.configFlash.valvesControlConfig.valveControlConfig[idx].controlFlags.allow==piControlAllowedHeatingCooling) || (VdmConfig.configFlash.valvesControlConfig.valveControlConfig[idx].controlFlags.allow==piControlAllowedHeating))
      {
        return(control); 
      }
      else {
        return(gotoMin);  
      }
    case piControlOnCooling:
      if ((VdmConfig.configFlash.valvesControlConfig.valveControlConfig[idx].controlFlags.allow==piControlAllowedHeatingCooling) || (VdmConfig.configFlash.valvesControlConfig.valveControlConfig[idx].controlFlags.allow==piControlAllowedCooling))
      {
        return(control); 
      }
      else {
        return(gotoMin);  
      }
    case piControlOff:
      return (gotoPark);
  } 
  return (nothing);
}


uint8_t CPiControl::calcValve()
{
  float piValue=0;
  piValue=piCtrl(target,value);
  return (round(piValue));
}

void CPiControl::controlValve() 
{
  CHECKACTION check=checkAction(valveIndex);
 
  switch (check) {
    case nothing:
      break;
    case gotoMin:
      // the valve range decides what 0 % means for the valve: closed or its smallest opening
      setPosition(0);
      break;
    case gotoPark:
      setPosition(VdmConfig.heatValues.parkPosition);
      break;
    case control:
      doControlValve();
      break;
  }
}

void CPiControl::setPosition(uint8_t thisPosition)
{
  if (!isStarted()) return;
  StmApp.actuators[valveIndex].target_position=thisPosition;
     // check if there are links
     for (uint8_t i=0; i< ACTUATOR_COUNT; i++) {
      if (VdmConfig.configFlash.valvesControlConfig.valveControlConfig[i].controlFlags.active) {
        if (VdmConfig.configFlash.valvesControlConfig.valveControlConfig[i].link==(valveIndex+1)) {
          StmApp.actuators[i].target_position=thisPosition;
          if (VdmConfig.configFlash.netConfig.syslogLevel>=VISMODE_DETAIL) {
            syslog.log(LOG_DEBUG, "pic:link valve position has changed to : "+String(VdmConfig.configFlash.valvesConfig.valveConfig[i].name)+"(#"+String(i+1)+") = "+String(thisPosition));
          }
        }
      }
    }
}
  
bool CPiControl::getValueFromSource()
{
  if (!isStarted()) return (false);
  if (VdmConfig.configFlash.valvesControlConfig.valveControlConfig[valveIndex].valueSource==1) {
      if (StmApp.actuators[valveIndex].temp1>-500) 
        value=((float)StmApp.actuators[valveIndex].temp1)/10;
      else return (false);
    }
    if (VdmConfig.configFlash.valvesControlConfig.valveControlConfig[valveIndex].valueSource==2) {
      if (StmApp.actuators[valveIndex].temp2>-500) 
        value=((float)StmApp.actuators[valveIndex].temp2)/10;
      else return (false);
    }
    return (true);
}

void CPiControl::doControlValve() 
{
    uint8_t valvePosition;
    if (!getValueFromSource()) return;
    if (!std::isfinite(target) || !std::isfinite(value)) return;
    // deadband
    if (VdmConfig.configFlash.valvesControl1Config.valveControl1Config[valveIndex].deadband>0) {
      if (abs(target-value)<VdmConfig.configFlash.valvesControl1Config.valveControl1Config[valveIndex].deadband) return;
    }
    float newValveValue=calcValve();
    valvePosition=round(newValveValue);
    if (valvePosition>100) {
      if (VdmConfig.configFlash.netConfig.syslogLevel>=VISMODE_DETAIL) {
        syslog.log(LOG_DEBUG, "pic:valve position exceeds 100 : (#"+String(valveIndex+1)+") = "+String(valvePosition));
      }
      valvePosition=100;
    }
    if (controlActive==0) valvePosition=0; 
    setPosition(valvePosition);
    lastControlPosition=valvePosition;
    savePiControl();
}
  
void CPiControl::setControlActive(uint8_t thisControl)
{
  controlActive=thisControl;
  if (!isStarted()) return;
  // check if there are links
   for (uint8_t i=0; i< ACTUATOR_COUNT; i++) {
    if (VdmConfig.configFlash.valvesControlConfig.valveControlConfig[i].controlFlags.active) {
      if (VdmConfig.configFlash.valvesControlConfig.valveControlConfig[i].link==(valveIndex+1)) {
        PiControl[i].controlActive=thisControl;
      }
    }
  }
}

void CPiControl::setFailed(uint8_t thisPosition)
{
  failed=true;
  if (!isStarted()) return;
  StmApp.actuators[valveIndex].target_position=thisPosition;
  // check if there are links
  for (uint8_t i=0; i< ACTUATOR_COUNT; i++) {
    if (VdmConfig.configFlash.valvesControlConfig.valveControlConfig[i].link==(valveIndex+1)) {
      StmApp.actuators[i].target_position=thisPosition;
    }
  }
}
