stefan-schweiger/VdMot_Controller/software_esp32/src/tfs_data.c

#include <tfs.h>

extern const TFS_DIR_ENTRY tfs_data[];

static const unsigned char tfs____web_pages_blank_png[] = {
	/* ../web_pages/blank.png */
	0x1f, 0x8b, 0x08, 0x00, 0x00, 0x00, 0x00, 0x00, 0x02, 0xff,
	0xeb, 0x0c, 0xf0, 0x73, 0xe7, 0xe5, 0x92, 0xe2, 0x62, 0x60,
	0x60, 0xe0, 0xf5, 0xf4, 0x70, 0x09, 0x62, 0x60, 0x60, 0x62,
	0x00, 0x61, 0x0e, 0x36, 0x20, 0xf5, 0xa5, 0xe2, 0xca, 0x2f,
	0x20, 0xc5, 0x59, 0xe0, 0x11, 0x59, 0x0c, 0x94, 0xbf, 0x0e,
	0xc2, 0x8c, 0x4e, 0x1a, 0xb3, 0x2b, 0x80, 0x82, 0xb2, 0x99,
	0x21, 0x11, 0x25, 0xc1, 0xf9, 0x69, 0x25, 0xe5, 0x89, 0x45,
	0xa9, 0x0c, 0x20, 0x50, 0x5e, 0x5e, 0xae, 0x97, 0x99, 0x97,
	0x5d, 0x9c, 0x9c, 0x58, 0x90, 0xaa, 0x97, 0x5f, 0x94, 0xfe,
	0xa6, 0x2b, 0x7a, 0x23, 0x03, 0x03, 0x0b, 0xbf, 0xa7, 0x8b,
	0x63, 0x48, 0xc5, 0xad, 0xb7, 0x07, 0x0d, 0x19, 0x81, 0x8a,
	0x0e, 0x2d, 0xf8, 0xea, 0x9f, 0xcb, 0x9e, 0xbf, 0x80, 0x61,
	0x14, 0x8c, 0x82, 0x51, 0x30, 0xe2, 0xc0, 0x03, 0x73, 0xa6,
	0x0f, 0x0c, 0x8c, 0xfa, 0xb7, 0x0e, 0x78, 0x83, 0x78, 0x9e,
	0xae, 0x7e, 0x2e, 0xeb, 0x9c, 0x12, 0x9a, 0x00, 0x44, 0xd7,
	0x04, 0x82, 0x86, 0x04, 0x00, 0x00
};

static const unsigned char tfs____web_pages_favicon_ico[] = {
	/* ../web_pages/favicon.ico */
	0x1f, 0x8b, 0x08, 0x00, 0x00, 0x00, 0x00, 0x00, 0x02, 0xff,
	0xed, 0x5a, 0x4d, 0x4c, 0x1b, 0x47, 0x14, 0x7e, 0xeb, 0x75,
	0x30, 0x3f, 0x0e, 0x36, 0x49, 0x13, 0x22, 0x41, 0x6a, 0x12,
	0x42, 0x82, 0x4d, 0xfe, 0x44, 0xec, 0xa5, 0x40, 0x13, 0x9a,
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
	0xed, 0x60, 0x37, 0x1b, 0x71, 0xf7, 0xec, 0x8a, 0x13, 0xb1,
	0xf3, 0x0b, 0xf2, 0x11, 0xfb, 0x88, 0x71, 0xf4, 0xe0, 0xa3,
	0xab, 0x1f, 0x6f, 0xa8, 0xcc, 0xde, 0x85, 0x2c, 0x7b, 0x9a,
	0x7d, 0xc3, 0x69, 0x1e, 0x94, 0x2e, 0xb3, 0xa0, 0x34, 0xe4,
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
};

const TFS_DIR_ENTRY tfs_data[] = {
	{ "/blank.png", 0, (unsigned char*)tfs____web_pages_blank_png, sizeof(tfs____web_pages_blank_png) },
	{ "/favicon.ico", 0, (unsigned char*)tfs____web_pages_favicon_ico, sizeof(tfs____web_pages_favicon_ico) },
	{ "/index.html", 0, (unsigned char*)tfs____web_pages_index_html, sizeof(tfs____web_pages_index_html) },
	{ "/stmupdate.html", 0, (unsigned char*)tfs____web_pages_stmupdate_html, sizeof(tfs____web_pages_stmupdate_html) },
	{ "/warning_red.png", 0, (unsigned char*)tfs____web_pages_warning_red_png, sizeof(tfs____web_pages_warning_red_png) },
	{ "/warning_yellow.png", 0, (unsigned char*)tfs____web_pages_warning_yellow_png, sizeof(tfs____web_pages_warning_yellow_png) },
	{ "/window_close.png", 0, (unsigned char*)tfs____web_pages_window_close_png, sizeof(tfs____web_pages_window_close_png) },
	{ "/window_gray.png", 0, (unsigned char*)tfs____web_pages_window_gray_png, sizeof(tfs____web_pages_window_gray_png) },
	{ "/window_open.png", 0, (unsigned char*)tfs____web_pages_window_open_png, sizeof(tfs____web_pages_window_open_png) },
	{ 0, 0, 0, 0 }
};
