stefan-schweiger/VdMot_Controller/software_esp32/src/Services.cpp

/**HEADER*******************************************************************
  project : VdMot Controller

  author : SurfGargano, Lenti84

  Comments:

  Version :

  Modifcations :


***************************************************************************
*
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
  Copyright (C) 2021 Lenti84  https://github.com/Lenti84/VdMot_Controller

*END************************************************************************/


#include "Services.h"
#include "globals.h"
#include "VdmTask.h"
#include "VdmConfig.h"
#include "VdmSystem.h"
#include "VdmNet.h"
#include "stmApp.h"
#include "Queue.h"
#include "Messenger.h"
#include "PIControl.h"
#include "RtcRam.h"


CServices Services;

CServices::CServices()
{
  serviceValvesStarted=false;
  restartKeepsStm=false;
  for (uint8_t x = 0;x<TEMP_SENSORS_COUNT;x++) 
    tempStates[x].timeOut=0;  
}

void CServices::checkServiceValves()
{
  struct tm timeinfo;
  //UART_DBG.println("checkServiceValves");
  if (VdmNet.sntpActive) {
    if (VdmSystem.getLocalTime(&timeinfo)) {
      uint8_t i = 1<<timeinfo.tm_wday;
      time_t now;
      time (&now);
        
      if ((VdmConfig.configFlash.valvesConfig.dayOfCalib & i) !=0) { // day fits
        if (VdmConfig.configFlash.valvesConfig.hourOfCalib==timeinfo.tm_hour) { // hour fits
            if (!serviceValvesStarted) {
              serviceValvesStarted=true;
              // start service valves
              StmApp.valvesCalibration(255);
            }
        } else serviceValvesStarted=false;
      }
    }
  }
}

// true if the temperature sensor (index in tempsConfig) is the pi control value source of the valve
static bool isValueSourceSensor(uint8_t valveIdx, int8_t tempIdx)
{
  uint8_t source = VdmConfig.configFlash.valvesControlConfig.valveControlConfig[valveIdx].valueSource;
  return (((source==1) && (StmApp.actuators[valveIdx].tIdx1==tempIdx+1)) ||
          ((source==2) && (StmApp.actuators[valveIdx].tIdx2==tempIdx+1)));
}

void CServices::checkDS18()
{
  int8_t tempIdx;
  int8_t valveIdx;
  bool messengerToSend=false;
  String title = String(VdmConfig.configFlash.systemConfig.stationName) + " : SYSTEM" ;
  String s = "DS18 sensor failed for room\r\n";

  for (uint8_t x = 0;x<StmApp.tempsCount;x++) {
    tempIdx=StmApp.findTempID(StmApp.temps[x].id);  // starts with 0 
    if (tempIdx>=0) {
      if (VdmConfig.configFlash.tempsConfig.tempConfig[tempIdx].active) {
        tempStates[tempIdx].tempFailed=(StmApp.temps[x].temperature<=-500);
        if (tempStates[tempIdx].tempFailed) {
            tempStates[tempIdx].timeOut++;
            if (tempStates[tempIdx].timeOut>4) {
              if (!tempStates[tempIdx].messengerSent) {
                s+=String(VdmConfig.configFlash.tempsConfig.tempConfig[tempIdx].name)+"\r\n";
                tempStates[tempIdx].messengerSent=true;
                messengerToSend=true;
              }
              tempStates[tempIdx].timeOut=0;
              if (VdmConfig.configFlash.protConfig.mqttConfig.flags.timeoutDSActive) {
                for (valveIdx=0; valveIdx<ACTUATOR_COUNT; valveIdx++) {
                  if (isValueSourceSensor(valveIdx, tempIdx)) PiControl[valveIdx].setFailed(VdmConfig.configFlash.protConfig.mqttConfig.toPos);
                }
              }
            }
        }
      }
      if (!tempStates[tempIdx].tempFailed) {
        tempStates[tempIdx].messengerSent= false;
        tempStates[tempIdx].timeOut=0;
        // sensor is back, release the pi control of the valves which use it as value source
        for (valveIdx=0; valveIdx<ACTUATOR_COUNT; valveIdx++) {
          if (isValueSourceSensor(valveIdx, tempIdx)) PiControl[valveIdx].failed=false;
        }
      }
    }
  }
  if (VdmConfig.configFlash.messengerConfig.reason.reasonFlags.ds18Failed) {
    if (messengerToSend) Messenger.sendMessage (title.c_str(),s.c_str());
  }
}

void CServices::checkGetNtp()
{
  // check if time is 3:05 am
  if (VdmNet.sntpActive) {
    VdmNet.sntpReachable=VdmNet.checkSntpReachable();
    #ifdef EnvDevelop
        UART_DBG.println("checkGetNtp : "+String(VdmNet.sntpReachable));
    #endif
    if (VdmNet.sntpReachable) {
      if (VdmSystem.getLocalTime(&VdmNet.startTimeinfo)) {
        if ((VdmNet.startTimeinfo.tm_hour==getNtpHour) && (VdmNet.startTimeinfo.tm_min==getNtpMin)) {
          VdmNet.setupNtp();
        }
      }
    }
    else 
    {
      VdmNet.setupNtp(); 
    }
  }
}

void CServices::servicesLoop()
{
  checkServiceValves();  
  checkGetNtp();
  VdmNet.checkWifi();
  checkDS18();
}

void CServices::runOnce() 
{
  VdmNet.setupNtp();
  StmApp.getParametersFromSTM();
}

void CServices::runOnceDelayed10()
{
  VdmTask.startApp();
  GetLastTargetValues();
  VdmNet.startBroker();
  checkGetNtp();
}

void CServices::runOnceDelayed60()
{
  VdmTask.startPIServices();
  VdmTask.piTaskInitiated=true;
}

void CServices::GetLastTargetValues()
{
  for (uint8_t picIdx=0; picIdx<ACTUATOR_COUNT; picIdx++) { 
    if (VdmConfig.configFlash.valvesControlConfig.valveControlConfig[picIdx].controlFlags.active) {
      if (VdmConfig.configFlash.valvesControlConfig.valveControlConfig[picIdx].link==0) { 
          PiControl[picIdx].valveIndex=picIdx;
          PiControl[picIdx].reloadPiControl();
      }
    }
  }
}

// keepStm: the STM32 keeps running with its valve positions and learned strokes, see setup()
void CServices::restartSystem(bool waitQueueFinished, bool keepStm) {
  #ifdef EnvDevelop
    UART_DBG.println("restart System ");
  #endif
  restartKeepsStm=keepStm;
  if (StmApp.waitEEPFinished) {
    StmApp.eepState=EEP_REQUEST; 
  }
  if (StmApp.waitForFinishQueue || StmApp.waitEEPFinished) {
        #ifdef EnvDevelop
          UART_DBG.println("wait for finish queue");
        #endif
        VdmTask.taskIdResetSystem = taskManager.scheduleOnce(60*1000, [] {
                #ifdef EnvDevelop
                  UART_DBG.println("wait for finish queue timeout, restart now");
                #endif
                delay (1000);
                Services.restartNow();
            });
        VdmTask.taskIdwaitForFinishQueue = taskManager.scheduleFixedRate(500, [] {
          int restartNow = 0;
          if (StmApp.waitForFinishQueue) restartNow=Queue.available();
          if (StmApp.waitEEPFinished) {
            if ((StmApp.eepState!=EEP_DONE) && (StmApp.eepState!=EEP_IDLE)) restartNow++; 
            #ifdef EnvDevelop
              UART_DBG.println("waiting eep finished "+String(StmApp.eepState));
            #endif
          } 
          if (restartNow==0) {
              #ifdef EnvDevelop
                UART_DBG.println("queue/eeprom finished, restart now");
              #endif
              StmApp.eepState=EEP_IDLE;
                VdmTask.taskIdResetSystem = taskManager.scheduleOnce(3000, [] {
                  Services.restartNow();
                });
                VdmTask.deleteTask(VdmTask.taskIdwaitForFinishQueue);
          }
        });
    } else {
      #ifdef EnvDevelop
        UART_DBG.println("normal restart");
      #endif
      VdmTask.taskIdResetSystem = taskManager.scheduleOnce(2000, [] {
              Services.restartNow();
            });
    }
}

void CServices::restartNow() {
  keepStmRunning = restartKeepsStm ? KEEP_STM_RUNNING : 0;
  ESP.restart();
}

void CServices::restartStmApp(uint32_t ms) {
      VdmTask.restartStmApp = taskManager.scheduleOnce(ms, [] {
                VdmTask.startApp();
            });
}
