stefan-schweiger/VdMot_Controller/software_esp32/src/ServerServices.cpp

/**HEADER*******************************************************************
  project : VdMot Controller

  author : SurfGargano, Lenti84

  Comments:

  Version :

  Modifcations :


***************************************************************************
*
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
  Copyright (C) 2021 Lenti84  https://github.com/Lenti84/VdMot_Controller

*END************************************************************************/


#include <stdint.h>
#include <VdmNet.h>
#include <WiFi.h>
#include <WiFiClient.h>

#include "globals.h"
#include "WT32AsyncOTA.h"

#include "web.h"
#include "tfs.h"

#include "time.h"

#include "stm32.h"
#include "stm32ota.h"
#include <ESPmDNS.h>
#include <WiFiUdp.h>
#include "ServerServices.h"
#include "VdmSystem.h"
#include "VdmTask.h"
#include "Services.h"
#include "stmApp.h"
#include "PIControl.h"
#include "Messenger.h"
#include "mqtt.h"

#include <FS.h>
#ifdef USE_LittleFS
  #define SPIFFS LittleFS
  #include <LittleFS.h> 
#else
  #include <SPIFFS.h>
#endif 

extern "C" {
  #include "tfs_data.h"
}


#include <AsyncJson.h>
#include <ArduinoJson.h>
#include <mutex>

AsyncWebServer server(80);

CServerServices ServerServices;

#define aj  "application/json"
#define tp  "text/plain"
#define th  "text/html"
#define gz  "Content-Encoding : gzip"

#define resOk "{\"res\":\"ok\"}"

// server handles --------------------------------------------------

// the /cmd actions run on the main loop like the other tasks and not in the web server task: they write
// the nvs, start and stop tasks or talk to the STM32 and the broker, and the web server task is reset by
// the task watchdog if a request takes 5 s
struct CMD_REQUEST;
typedef void (*CmdFn)(const CMD_REQUEST& cmd);

struct CMD_REQUEST {
  CmdFn fn;
  uint8_t valve;          // index, 255 = all valves
  uint8_t arg;            // discoveryHA: action, STM32 update: command
  bool restart;           // saveCfg: the network settings changed
  char file[96];
};

#define CMD_QUEUE_SIZE 8

static CMD_REQUEST cmdQueue[CMD_QUEUE_SIZE];
static uint8_t cmdFirst = 0;
static uint8_t cmdCount = 0;
static std::mutex cmdMutex;

static void runQueuedCmds()
{
  CMD_REQUEST cmd;
  while (true) {
    {
      std::lock_guard<std::mutex> lock(cmdMutex);
      if (cmdCount==0) return;
      cmd=cmdQueue[cmdFirst];
      cmdFirst=(cmdFirst+1)%CMD_QUEUE_SIZE;
      cmdCount--;
    }
    cmd.fn(cmd);
  }
}

// queues the command for the main loop, in the order of the requests, false if too many are waiting
static bool queueCmd(const CMD_REQUEST& cmd)
{
  {
    std::lock_guard<std::mutex> lock(cmdMutex);
    if (cmdCount>=CMD_QUEUE_SIZE) return false;
    cmdQueue[(cmdFirst+cmdCount)%CMD_QUEUE_SIZE]=cmd;
    cmdCount++;
  }
  taskManager.execute(runQueuedCmds);
  return true;
}

static void restart (const CMD_REQUEST& cmd)
{  
  Services.restartSystem(false);
}

static void saveConfig (const CMD_REQUEST& cmd)
{  
  VdmConfig.saveConfig(cmd.restart);
}

static void resetConfig (const CMD_REQUEST& cmd)
{  
  VdmConfig.resetConfig(true);
}

static void restoreConfig (const CMD_REQUEST& cmd)
{  
  VdmConfig.restoreConfig(true);
}

static void setClearFS (const CMD_REQUEST& cmd)
{  
  VdmTask.startClearFS();
}

static void setGetFS (const CMD_REQUEST& cmd)
{  
  VdmTask.startGetFS();
}

static void fileDelete (const CMD_REQUEST& cmd)
{  
  if (strlen(cmd.file)>0) VdmSystem.fileDelete(cmd.file);
}

static void scanTSensors (const CMD_REQUEST& cmd)
{  
  StmApp.scanTemps();
}

static void valvesCalibration (const CMD_REQUEST& cmd)
{  
  StmApp.valvesCalibration(cmd.valve);
}

static void valvesAssembly (const CMD_REQUEST& cmd)
{  
  StmApp.valvesAssembly(cmd.valve);
}

static void valvesDetect (const CMD_REQUEST& cmd)
{  
  StmApp.valvesDetect();
}

static void writeValvesControl (const CMD_REQUEST& cmd)
{  
  VdmConfig.writeValvesControlConfig(false,VdmTask.restartPiTask);
  Mqtt.forceReconnect=true;
}

static void mqttReconnect (const CMD_REQUEST& cmd)
{  
  Mqtt.disconnect();
}

static void sysLogSave (const CMD_REQUEST& cmd)
{  
  VdmConfig.writeSysLogValues();
  VdmNet.syslogStarted=false;
  VdmNet.startSysLog();
}

static void discoveryHA (const CMD_REQUEST& cmd)
{  
  if (Mqtt.hadState==HAD_IDLE) {
    Mqtt.actionHA = (ACTION_HA) cmd.arg;
    Mqtt.hadState=HAD_STARTED;
  }
}

static void stmUpdate (const CMD_REQUEST& cmd)
{
  if (cmd.arg==0) VdmTask.startStm32Ota(STM32OTA_START,cmd.file);
  if (cmd.arg==1) VdmTask.startStm32Ota(STM32OTA_STARTBLANK,cmd.file);
}

void CServerServices::postSetValve (JsonObject doc)
{
  uint8_t index;
  if (!doc["valve"].isNull()) {
    index=(doc["valve"].as<uint8_t>())-1;
    if (index<ACTUATOR_COUNT) {
      if (VdmConfig.configFlash.valvesConfig.valveConfig[index].active) {
        if (!doc["value"].isNull()) StmApp.actuators[index].target_position = doc["value"];
      }
      if (VdmConfig.configFlash.valvesControlConfig.valveControlConfig[index].controlFlags.active) {
        if (VdmConfig.configFlash.valvesControlConfig.valveControlConfig[index].valueSource==3) {
          if (!doc["ctrlValue"].isNull()) PiControl[index].value = doc["ctrlValue"];
          #ifdef EnvDevelop
            UART_DBG.println("ctrlValue : "+String(PiControl[index].value));
          #endif
          jsonSetValveReceived=true;
        }
        if (VdmConfig.configFlash.valvesControlConfig.valveControlConfig[index].targetSource==1) {
          if (!doc["ctrlTarget"].isNull()) {
            PiControl[index].target = doc["ctrlTarget"];
            #ifdef EnvDevelop
            UART_DBG.println("ctrlTarget : "+String(PiControl[index].target));
            #endif
            jsonSetValveReceived=true;
          }
          if (!doc["ctrlDynOffs"].isNull()) PiControl[index].dynOffset = doc["ctrlDynOffs"];
        }
      }
    }
  }
}

String getContentType(String filename) 
{ // convert the file extension to the MIME type
  if (filename.endsWith(".html")) return th;
  else if (filename.endsWith(".css")) return "text/css";
  else if (filename.endsWith(".js")) return "application/javascript";
  else if (filename.endsWith(".ico")) return "image/x-icon";
  else if (filename.endsWith(".gz")) return "application/x-gzip";
  return tp;
}

int8_t checkEntry (String url) 
{
  int8_t i = 0;
  TFS_DIR_ENTRY *entry = (TFS_DIR_ENTRY*) tfs_data;
  String thisUrl=url;
  if (url=="/") thisUrl = "/index.html";
 
  while (entry->NAME != NULL) {
      if (thisUrl == String(entry->NAME)) {
        return(i);
      }
      entry++;
      i++;
  }
  
  return(-1);
}

void handleRoot(AsyncWebServerRequest *request) 
{
  int8_t index;
  
  index=checkEntry(request->url());
  if (index>=0) {
    AsyncWebServerResponse *response = request->beginResponse_P(200, getContentType (tfs_data[index].NAME), 
                                      tfs_data[index].DATA, tfs_data[index].SIZE);
    response->addHeader("Content-Encoding", "gzip");
    request->send(response);
  } else {
    String message = "File "+request->url()+" Not Found\n\n"; 
    request->send(404, tp, message);
  }
}


void handleWebPageStmUpdate(AsyncWebServerRequest *request) 
{
  int8_t index;
  String thisUrl = request->url();
  if (!thisUrl.endsWith(".html")) thisUrl+=".html";
  index=checkEntry(thisUrl);
  if (index>=0) {
    AsyncWebServerResponse *response = request->beginResponse_P(200, getContentType (tfs_data[index].NAME), 
                                      tfs_data[index].DATA, tfs_data[index].SIZE);
    response->addHeader("Content-Encoding", "gzip");
    request->send(response);
  } else {
    String message = "File "+request->url()+" Not Found\n\n"; 
    request->send(404, tp, message);
  }
}

void handleNotFound(AsyncWebServerRequest *request)
{
  if (checkEntry(request->url())>=0) {
    handleRoot(request); 
  } else {

    String message = "File Not Found\n\n";

    message += "URI: ";
    //message += server.uri();
    message += request->url();
    message += "\nMethod: ";
    message += (request->method() == HTTP_GET) ? "GET" : "POST";
    message += "\nArguments: ";
    message += request->args();
    message += "\n";

    for (uint8_t i = 0; i < request->args(); i++) {
      message += " " + request->argName(i) + ": " + request->arg(i) + "\n";
    }
    request->send(404, tp, message);
  }
}

void handleValves(AsyncWebServerRequest *request)
{
  request->send(200,aj,Web.getValvesStatus());
}

void handleTemps(AsyncWebServerRequest *request)
{
  request->send(200,aj,Web.getTempsStatus(VdmConfig.configFlash.tempsConfig));
}

void handleVolts(AsyncWebServerRequest *request)
{
  request->send(200,aj,Web.getVoltsStatus(VdmConfig.configFlash.voltsConfig));
}

void handleNetInfo(AsyncWebServerRequest *request) 
{ 
  request->send(200,aj,Web.getNetInfo(VdmNet.networkInfo));
}

void handleNetConfig(AsyncWebServerRequest *request)
{
  request->send(200,aj,Web.getNetConfig(VdmConfig.configFlash.netConfig));
}

void handleProtConfig(AsyncWebServerRequest *request)
{
  request->send(200,aj,Web.getProtConfig(VdmConfig.configFlash.protConfig));
}

void handleValvesConfig(AsyncWebServerRequest *request)
{
  request->send(200,aj,Web.getValvesConfig (VdmConfig.configFlash.valvesConfig));
}

void handleMotorConfig(AsyncWebServerRequest *request)
{
  request->send(200,aj,Web.getMotorConfig (StmApp.motorChars));
}

void handleValvesControlConfig(AsyncWebServerRequest *request)
{
  request->send(200,aj,Web.getValvesControlConfig (VdmConfig.configFlash.valvesControlConfig));
}

void handleTempsConfig(AsyncWebServerRequest *request)
{
  request->send(200,aj,Web.getTempsConfig (VdmConfig.configFlash.tempsConfig));
}

void handleTempSensorsID(AsyncWebServerRequest *request)
{
  request->send(200,aj,Web.getTempSensorsID ());
}

void handleVoltsConfig(AsyncWebServerRequest *request)
{
  request->send(200,aj,Web.getVoltsConfig (VdmConfig.configFlash.voltsConfig));
}

void handleVoltSensorsID(AsyncWebServerRequest *request)
{
  request->send(200,aj,Web.getVoltSensorsID ());
}

void handleSysInfo(AsyncWebServerRequest *request) 
{ 
  request->send(200,aj,Web.getSysInfo());
}

void handleSysDynInfo(AsyncWebServerRequest *request) 
{ 
  request->send(200,aj,Web.getSysDynInfo());
}

void handleGetSysConfig(AsyncWebServerRequest *request) 
{ 
  request->send(200,aj,Web.getSysConfig(VdmConfig.configFlash.systemConfig));
}

// changes and secrets need http basic auth when a user name and password are configured,
// the web ui sends the credentials after login, other clients get the browser login
static bool isAuthorized(AsyncWebServerRequest *request)
{
  const char* user = VdmConfig.configFlash.netConfig.userName;
  const char* pwd = VdmConfig.configFlash.netConfig.userPwd;
  if ((strlen(user)==0) || (strlen(pwd)==0)) return true;
  return request->authenticate(user, pwd);
}

// answers with 401 if the request is not authorized
// no WWW-Authenticate header, the browser would show its login dialog for every api call of the ui
static bool checkAuthorized(AsyncWebServerRequest *request)
{
  if (isAuthorized(request)) return true;
  request->send(401, aj, "{\"auth\":0}");
  return false;
}

void handleGetMsgConfig(AsyncWebServerRequest *request) 
{ 
  // the tokens and passwords are only sent to authorized requests, the ui loads this page also without login
  VDM_MSG_CONFIG msgConfig = VdmConfig.configFlash.messengerConfig;
  if (!isAuthorized(request)) {
    memset(msgConfig.pushover.appToken,0,sizeof(msgConfig.pushover.appToken));
    memset(msgConfig.pushover.userToken,0,sizeof(msgConfig.pushover.userToken));
    memset(msgConfig.email.pwd,0,sizeof(msgConfig.email.pwd));
  }
  request->send(200,aj,Web.getMsgConfig(msgConfig));
}

void handleGetStm(AsyncWebServerRequest *request) 
{ 
  // generate callback with request parameter
  // send request answer after getting from stm 
}

void handleGetFSDir(AsyncWebServerRequest *request) 
{ 
  request->send(200,aj,Web.getFSDir());
}

void handleStmUpdStatus(AsyncWebServerRequest *request) 
{ 
  request->send(200,aj,Web.getStmUpdStatus());
}


// queues the action of a /cmd request, the answer is empty for an unknown action
static String handleCmd(JsonObject doc) 
{ 
  static const struct {
    const char* name;
    CmdFn fn;
  } cmds[] = {
    {"reboot",&restart}, {"saveCfg",&saveConfig}, {"resetCfg",&resetConfig}, {"restoreCfg",&restoreConfig},
    {"fDelete",&fileDelete}, {"getFS",&setGetFS}, {"clearFS",&setClearFS}, {"scanTempSensors",&scanTSensors},
    {"vCalib",&valvesCalibration}, {"vAssembly",&valvesAssembly}, {"valvesDetect",&valvesDetect},
    {"vCtrlSave",&writeValvesControl}, {"mqttReconnect",&mqttReconnect}, {"sysLogSave",&sysLogSave},
    {"discoveryHA",&discoveryHA}
  };

  const char* action=doc["action"] | "";
  for (const auto& c : cmds) {
    if (strcmp(action, c.name)!=0) continue;

    CMD_REQUEST cmd={};
    cmd.fn=c.fn;
    // valve is 1 based, 255 = all valves
    cmd.valve=255;
    if (!doc["valve"].isNull()) {
      cmd.valve=doc["valve"].as<uint8_t>();
      if (cmd.valve!=255) cmd.valve--;
    }
    cmd.arg=doc["actionHA"].isNull() ? HA_DISCOVERY_ONLY : doc["actionHA"].as<uint8_t>();
    strlcpy(cmd.file, doc["file"] | "", sizeof(cmd.file));
    // the page shows the answer: saved or restarting
    if (c.fn==&saveConfig) cmd.restart=VdmConfig.networkChanged();
    if (!queueCmd(cmd)) return "{\"res\":\"busy\"}";
    if (c.fn==&saveConfig) return cmd.restart ? "{\"res\":\"ok\",\"restart\":true}" : "{\"res\":\"ok\",\"restart\":false}";
    return resOk;
  }
  return "";
}

void handleUploadFile(AsyncWebServerRequest *request, const String& filename, size_t index, 
            uint8_t *data, size_t len, bool final)
{
  bool authorized = isAuthorized(request);
  if(!index && authorized){
    String thisFileName = filename;
    // open the file on first call and store the file handle in the request object
    #ifdef EnvDevelop
      UART_DBG.println("file has arguments : "+String(request->args()));
    #endif
    if (request->args()) {
        #ifdef EnvDevelop      
          UART_DBG.println("file has argument "+request->arg("dir"));
        #endif
        thisFileName = "/"+filename; 
    }
    #ifdef EnvDevelop
      UART_DBG.println("filename : "+thisFileName);
    #endif
    request->_tempFile = SPIFFS.open(thisFileName, "w");
  }
  if(len && request->_tempFile) {
    // stream the incoming chunk to the opened file
    request->_tempFile.write(data,len);
  }
  if(final){
    // close the file handle as the upload is now done
    if (request->_tempFile) request->_tempFile.close();
    if (!authorized) return request->send(401, aj, "{\"auth\":0}");
    request->send(200, aj, Web.getFSDir()); 
    #ifdef EnvDevelop
      UART_DBG.println("upload finished");
    #endif
  }
  
}

CServerServices::CServerServices()
{
  jsonSetValveReceived=false;
}

void CServerServices::stmDoUpdate(JsonObject doc)
{
  if (!doc["file"].isNull() && !doc["cmd"].isNull()) {
    CMD_REQUEST cmd={};
    String thisFileName = doc["file"] | "";
    if (!thisFileName.startsWith("/")) thisFileName = "/"+thisFileName;
    #ifdef EnvDevelop
      UART_DBG.println("file : "+thisFileName + " Command "+ String(doc["cmd"].as<uint8_t>()));
    #endif
    cmd.fn=&stmUpdate;
    cmd.arg=doc["cmd"];
    strlcpy(cmd.file, thisFileName.c_str(), sizeof(cmd.file));
    queueCmd(cmd);
  }
}

void  CServerServices::initServer() 
{
  // define on events
  server.on("/", HTTP_GET, [](AsyncWebServerRequest * request) {handleRoot(request);});
  server.onNotFound(handleNotFound);
  server.on("/valves",HTTP_GET,[](AsyncWebServerRequest * request) {handleValves(request);});
  server.on("/temps",HTTP_GET,[](AsyncWebServerRequest * request) {handleTemps(request);});
  server.on("/volts",HTTP_GET,[](AsyncWebServerRequest * request) {handleVolts(request);});
  server.on("/netinfo",HTTP_GET,[](AsyncWebServerRequest * request) {handleNetInfo(request);});
  server.on("/netconfig",HTTP_GET,[](AsyncWebServerRequest * request) {handleNetConfig(request);});
  server.on("/protconfig",HTTP_GET,[](AsyncWebServerRequest * request) {handleProtConfig(request);});
  server.on("/valvesconfig",HTTP_GET,[](AsyncWebServerRequest * request) {handleValvesConfig(request);});
  server.on("/motorconfig",HTTP_GET,[](AsyncWebServerRequest * request) {handleMotorConfig(request);});
  server.on("/valvesctrlconfig",HTTP_GET,[](AsyncWebServerRequest * request) {handleValvesControlConfig(request);});
  server.on("/tempsconfig",HTTP_GET,[](AsyncWebServerRequest * request) {handleTempsConfig(request);});
  server.on("/voltsconfig",HTTP_GET,[](AsyncWebServerRequest * request) {handleVoltsConfig(request);});
  server.on("/sysinfo",HTTP_GET,[](AsyncWebServerRequest * request) {handleSysInfo(request);});
  server.on("/sysdyninfo",HTTP_GET,[](AsyncWebServerRequest * request) {handleSysDynInfo(request);});
  server.on("/fsdir",HTTP_GET,[](AsyncWebServerRequest * request) {handleGetFSDir(request);});
  server.on("/stmupdate", HTTP_GET, [](AsyncWebServerRequest * request) {handleWebPageStmUpdate(request);});
  server.on("/stmupdstatus", HTTP_GET, [](AsyncWebServerRequest * request) {handleStmUpdStatus(request);});
  server.on("/tempsensorsid", HTTP_GET, [](AsyncWebServerRequest * request) {handleTempSensorsID(request);});
  server.on("/voltsensorsid", HTTP_GET, [](AsyncWebServerRequest * request) {handleVoltSensorsID(request);});
  server.on("/sysconfig", HTTP_GET, [](AsyncWebServerRequest * request) {handleGetSysConfig(request);});
  server.on("/msgconfig", HTTP_GET, [](AsyncWebServerRequest * request) {handleGetMsgConfig(request);});
  server.on("/stm?", HTTP_GET, [](AsyncWebServerRequest * request) {handleGetStm(request);});
  
  server.on("/fupload", HTTP_POST, [](AsyncWebServerRequest *request) {},
      [](AsyncWebServerRequest *request, const String& filename, size_t index, uint8_t *data,
                    size_t len, bool final) {handleUploadFile(request, filename, index, data, len, final);}
  );

  AsyncCallbackJsonWebHandler* stmDoUpdateHandler = new AsyncCallbackJsonWebHandler("/stmdoupdate", [](AsyncWebServerRequest *request, JsonVariant &json) {
    if (!checkAuthorized(request)) return;
    if (json.is<JsonObject>()) {
      JsonObject&& jsonObj = json.as<JsonObject>();
      ServerServices.stmDoUpdate (jsonObj);
      request->send(200, aj, resOk);
    } else request->send(400, tp, "Not an object");
  });
  server.addHandler(stmDoUpdateHandler);

  AsyncCallbackJsonWebHandler* setValveHandler = new AsyncCallbackJsonWebHandler("/setvalve", [](AsyncWebServerRequest *request, JsonVariant &json) {
    if (!checkAuthorized(request)) return;
    if (json.is<JsonObject>()) {
      JsonObject&& jsonObj = json.as<JsonObject>();
      ServerServices.postSetValve (jsonObj);
      request->send(200, aj, resOk);
    } else request->send(400, tp, "Not an object");
  });
  server.addHandler(setValveHandler);

  AsyncCallbackJsonWebHandler* netCfgHandler = new AsyncCallbackJsonWebHandler("/netconfig", [](AsyncWebServerRequest *request, JsonVariant &json) {
    if (!checkAuthorized(request)) return;
    if (json.is<JsonObject>()) {
      JsonObject&& jsonObj = json.as<JsonObject>();
      VdmConfig.postNetCfg (jsonObj);
      request->send(200, aj, resOk);
    } else request->send(400, tp, "Not an object");
  });
  server.addHandler(netCfgHandler);

  AsyncCallbackJsonWebHandler* sysLogCfgHandler = new AsyncCallbackJsonWebHandler("/sysLogCfg", [](AsyncWebServerRequest *request, JsonVariant &json) {
    if (!checkAuthorized(request)) return;
    if (json.is<JsonObject>()) {
      JsonObject&& jsonObj = json.as<JsonObject>();
      VdmConfig.postSysLogCfg (jsonObj);
      request->send(200, aj, resOk);
    } else request->send(400, tp, "Not an object");
  });
  server.addHandler(sysLogCfgHandler);  
  
  AsyncCallbackJsonWebHandler* protCfgHandler = new AsyncCallbackJsonWebHandler("/protconfig", [](AsyncWebServerRequest *request, JsonVariant &json) {
    if (!checkAuthorized(request)) return;
    if (json.is<JsonObject>()) {
      JsonObject&& jsonObj = json.as<JsonObject>();
      VdmConfig.postProtCfg (jsonObj);
      request->send(200, aj, resOk);
    } else request->send(400, tp, "Not an object");
  });
  server.addHandler(protCfgHandler);

  AsyncCallbackJsonWebHandler* valvesCfgHandler = new AsyncCallbackJsonWebHandler("/valvesconfig", [](AsyncWebServerRequest *request, JsonVariant &json) {
    if (!checkAuthorized(request)) return;
    if (json.is<JsonObject>()) {
      JsonObject&& jsonObj = json.as<JsonObject>();
      VdmConfig.postValvesCfg (jsonObj);
      request->send(200, aj, resOk);
    } else request->send(400, tp, "Not an object");
  });
  server.addHandler(valvesCfgHandler);
  
AsyncCallbackJsonWebHandler* valvesControlCfgHandler = new AsyncCallbackJsonWebHandler("/valvesctrlconfig", [](AsyncWebServerRequest *request, JsonVariant &json) {
    if (!checkAuthorized(request)) return;
    if (json.is<JsonObject>()) {
      JsonObject&& jsonObj = json.as<JsonObject>();
      VdmConfig.postValvesControlCfg (jsonObj);
      request->send(200, aj, resOk);
    } else request->send(400, tp, "Not an object");
  });
  server.addHandler(valvesControlCfgHandler);
  
  
  AsyncCallbackJsonWebHandler* tempsCfgHandler = new AsyncCallbackJsonWebHandler("/tempsconfig", [](AsyncWebServerRequest *request, JsonVariant &json) {
    if (!checkAuthorized(request)) return;
    if (json.is<JsonObject>()) {
      JsonObject&& jsonObj = json.as<JsonObject>();
      VdmConfig.postTempsCfg (jsonObj);
      request->send(200, aj, resOk);
    } else request->send(400, tp, "Not an object");
  });
  server.addHandler(tempsCfgHandler);

  AsyncCallbackJsonWebHandler* voltsCfgHandler = new AsyncCallbackJsonWebHandler("/voltsconfig", [](AsyncWebServerRequest *request, JsonVariant &json) {
    if (!checkAuthorized(request)) return;
    if (json.is<JsonObject>()) {
      JsonObject&& jsonObj = json.as<JsonObject>();
      VdmConfig.postVoltsCfg (jsonObj);
      request->send(200, aj, resOk);
    } else request->send(400, tp, "Not an object");
  });
  server.addHandler(voltsCfgHandler);

  AsyncCallbackJsonWebHandler* tempsAuthHandler = new AsyncCallbackJsonWebHandler("/auth", [](AsyncWebServerRequest *request, JsonVariant &json) {
    if (json.is<JsonObject>()) {
      JsonObject&& jsonObj = json.as<JsonObject>();
      String auth=VdmConfig.handleAuth (jsonObj);
      request->send(200, aj, auth);
    } else request->send(400, tp, "Not an object");
  });
  server.addHandler(tempsAuthHandler);

  AsyncCallbackJsonWebHandler* cmdHandler = new AsyncCallbackJsonWebHandler("/cmd", [](AsyncWebServerRequest *request, JsonVariant &json) {
    if (!checkAuthorized(request)) return;
    if (json.is<JsonObject>()) {
      JsonObject&& jsonObj = json.as<JsonObject>();
      String answer=handleCmd (jsonObj);
      if (answer.length()>0)
        request->send(200, aj, answer);
      else request->send(200, tp, "Cmd not found");
    } else request->send(400, tp, "Not an object");
  });
  server.addHandler(cmdHandler);

  AsyncCallbackJsonWebHandler* sysCfgHandler = new AsyncCallbackJsonWebHandler("/sysconfig", [](AsyncWebServerRequest *request, JsonVariant &json) {
    if (!checkAuthorized(request)) return;
    if (json.is<JsonObject>()) {
      JsonObject&& jsonObj = json.as<JsonObject>();
      VdmConfig.postSysCfg (jsonObj);
      request->send(200, aj, resOk);
    } else request->send(400, tp, "Not an object");
  });
  server.addHandler(sysCfgHandler);
  
AsyncCallbackJsonWebHandler* msgCfgHandler = new AsyncCallbackJsonWebHandler("/msgconfig", [](AsyncWebServerRequest *request, JsonVariant &json) {
    if (!checkAuthorized(request)) return;
    if (json.is<JsonObject>()) {
      JsonObject&& jsonObj = json.as<JsonObject>();
      VdmConfig.postMessengerCfg (jsonObj);
      request->send(200, aj, resOk);
    } else request->send(400, tp, "Not an object");
  });
  server.addHandler(msgCfgHandler);

AsyncCallbackJsonWebHandler* testPOHandler = new AsyncCallbackJsonWebHandler("/testPO", [](AsyncWebServerRequest *request, JsonVariant &json) {
    if (!checkAuthorized(request)) return;
    if (json.is<JsonObject>()) {
      JsonObject&& jsonObj = json.as<JsonObject>();
      Messenger.testPO(jsonObj);
      request->send(200, aj, resOk);
    } else request->send(400, tp, "Not an object");
  });
  server.addHandler(testPOHandler);  

AsyncCallbackJsonWebHandler* testEmailHandler = new AsyncCallbackJsonWebHandler("/testEmail", [](AsyncWebServerRequest *request, JsonVariant &json) {
    if (!checkAuthorized(request)) return;
    if (json.is<JsonObject>()) {
      JsonObject&& jsonObj = json.as<JsonObject>();
      Messenger.testEmail(jsonObj);
      request->send(200, aj, resOk);
    } else request->send(400, tp, "Not an object");
  });
  server.addHandler(testEmailHandler);  

  WT32AsyncOTA.begin(&server, isAuthorized);    // Start WT32OTA
  server.begin();
}
