stefan-schweiger/VdMot_Controller/software_stm32/src/owDevices.cpp

/**HEADER*******************************************************************
  project : VdMot Controller
  author : Lenti84
  Comments:
  Version :
  Modifcations :
***************************************************************************
*
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
**************************************************************************
  This program is free software: you can redistribute it and/or modify
  it under the terms of the GNU General Public License as published by
  the Free Software Foundation, either version 3 of the License.
  See the GNU General Public License for more details.
  You should have received a copy of the GNU General Public License
  along with this program.  If not, see <http://www.gnu.org/licenses/>.
  Copyright (C) 2021 Lenti84  https://github.com/Lenti84/VdMot_Controller
*END************************************************************************/

#include <Arduino.h>
#include "hardware.h"
#include <Wire.h>
#include "../lib/OneWire/OneWire.cpp"
#include <DallasTemperature.h>
#include <ArduinoJson.h>            // library https://github.com/bblanchon/ArduinoJson
#include "owDevices.h"
#include "DS2438.h"


tempsensor  tempsensors[MAXONEWIRECNT];
voltsensor  voltsensors[MAXDS2438CNT];
uint8_t     noOfDevices = 0;
uint8_t     noOfDS18Devices = 0;
uint8_t     noOfDS2438Devices = 0;

OneWire     oneWire(ONEW_PIN);

DallasTemperature sensors(&oneWire);
DS2438    bm(&oneWire);

enum t_state {T_INIT, T_IDLE, T_REQUEST, T_OUTPUT, T_READVAD, T_WAIT, T_SEARCH};

volatile int temp_cmd = 0;
volatile int lock = 0;

#define COMM_DBG				Serial6		// serial port for debugging


void printAddress(DeviceAddress deviceAddress)
{
  #if defined tempDebug || defined appDebug
    COMM_DBG.print("{");
    for (uint8_t i = 0; i < 8; i++)
    {  
      COMM_DBG.print(" ");
      if (deviceAddress[i] < 16) COMM_DBG.print("0");
      COMM_DBG.print(deviceAddress[i], HEX);
      if (i<7) COMM_DBG.print(", ");
      
    }
    COMM_DBG.print(" }");  
  #endif
}

void setDeviceAddress() {
   uint8_t thisSensorAddress[8];

   noOfDevices = sensors.getDeviceCount();
    #ifdef tempDebug
      COMM_DBG.print("Found "); 
      COMM_DBG.print(noOfDevices, 10); 
      COMM_DBG.println(" one wire sensors:");
    #endif
    for (unsigned int i=0; i<noOfDevices; i++)
    {
        sensors.getAddress(thisSensorAddress, i);
        if (thisSensorAddress[0] == 0x26) {
          if (noOfDS2438Devices >= MAXDS2438CNT) continue;      // array is full
          sensors.getAddress(voltsensors[noOfDS2438Devices].address, i);
          #ifdef tempDebug
            printAddress(voltsensors[noOfDS2438Devices].address);       
            COMM_DBG.println();
          #endif
          noOfDS2438Devices++;
         
        } else {
          if (sensors.validFamily(thisSensorAddress)) {
            if (noOfDS18Devices >= MAXONEWIRECNT) continue;       // array is full
            sensors.getAddress(tempsensors[noOfDS18Devices].address, i);
            #ifdef tempDebug
              printAddress(tempsensors[noOfDS18Devices].address);       
              COMM_DBG.println();
            #endif
            noOfDS18Devices++;
          }
        } 
        
    }
    #ifdef tempDebug
      COMM_DBG.print("Found "); 
      COMM_DBG.print(noOfDS18Devices, 10); 
      COMM_DBG.print(" temp sensors,");
      COMM_DBG.print(noOfDS2438Devices, 10); 
      COMM_DBG.println(" voltage sensors:");
    #endif
}

void temperature_setup() {
  uint8_t thisSensorAddress [8];

    #ifdef tempDebug
      COMM_DBG.println("starting 1-wire setup"); 
    #endif
    for (uint8_t i=0; i<MAXONEWIRECNT; i++)
    {
      memset (tempsensors[i].address,0x0,8);
    }

    sensors.begin();
  
    sensors.setWaitForConversion(false);
    #ifdef tempDebug
      COMM_DBG.println("search for devices"); 
    #endif
    setDeviceAddress();

    // init sensor array
    for (unsigned int i = 0; i<MAXONEWIRECNT; i++) {
      tempsensors[i].temperature = -500;
    }

    bm.begin();

}



void temperature_loop() {
    static enum t_state tempstate = T_INIT;
    static int substate = 0;
    static int devcnt = 0;
    static int devDS2438Cnt = 0;
    static unsigned int timer = 0;

    DeviceAddress currAddress;
    float temp = 0;
    float v = 0;

  switch (tempstate) {
    case T_INIT:  
              #ifdef tempDebug
                COMM_DBG.print("Found "); 
                COMM_DBG.print(noOfDevices, 10); 
                COMM_DBG.println(" temp sensors");
              #endif
              timer = CONV_INTERVALL / 10;                
              tempstate = T_IDLE;
              break;

    case T_IDLE:    

              if(temp_cmd == TEMP_CMD_NEWSEARCH) {
                substate = 0;
                tempstate = T_SEARCH;
              }
              else {
                if (lock == 0) {
                  tempstate = T_REQUEST;
                } 
              }

              break;

    case T_REQUEST:
              #ifdef tempDebug
                COMM_DBG.println("Requesting temperatures...");
              #endif
              sensors.requestTemperatures();

              timer = 20 + (sensors.millisToWaitForConversion(sensors.getResolution()) / 10);
              tempstate = T_WAIT;

              break;

    case T_WAIT:
              if(timer) timer--;
              else {
                devcnt=0;
                tempstate = T_OUTPUT;
              }
              break;
              
    case T_OUTPUT:  
              if(devcnt < noOfDS18Devices) {
                // by address, the index on the bus differs from the index in tempsensors if there are other devices
                temp = sensors.getTempC(tempsensors[devcnt].address);
                tempsensors[devcnt].temperature = round(temp*10);
                #ifdef tempDebug
                  COMM_DBG.print("Sensor temp ");
                  COMM_DBG.print(devcnt);
                  COMM_DBG.print(": ");
                  COMM_DBG.print(tempsensors[devcnt].temperature/10);
                  COMM_DBG.print(".");
                  COMM_DBG.print(tempsensors[devcnt].temperature%10);
                  COMM_DBG.println();  
                #endif
              }
              else {
                if (noOfDS2438Devices>0) {
                  tempstate = T_READVAD;
                  devDS2438Cnt = 0;
                }
                else tempstate = T_IDLE;
              }
              devcnt++;
              break;

    case T_READVAD:
              if (devDS2438Cnt<noOfDS2438Devices) {
                bm.setAddress(voltsensors[devDS2438Cnt].address);
                  v=bm.readVAD();
                  voltsensors[devDS2438Cnt].vad=100*v; // 10mV resolution
                  #ifdef tempDebug
                    COMM_DBG.print("Sensor voltage vad ");
                    COMM_DBG.print(devDS2438Cnt);
                    COMM_DBG.print(": ");
                    COMM_DBG.print(voltsensors[devDS2438Cnt].vad/100);
                    COMM_DBG.print(".");
                    COMM_DBG.print(voltsensors[devDS2438Cnt].vad%100);
                    COMM_DBG.println();  
                  #endif
                devDS2438Cnt++;
              }
              else {
                tempstate = T_IDLE;
              }
              break;

    case T_SEARCH:
              // start new search
              if (substate == 0) {
                #ifdef tempDebug
                  COMM_DBG.println("New 1-wire search");
                #endif
                sensors.begin();
                substate = 1;
                noOfDS18Devices = 0;
                noOfDS2438Devices = 0;
              }
              // read device count
              else if (substate == 1) {
                noOfDevices = sensors.getDeviceCount();
                #ifdef tempDebug
                  COMM_DBG.print("Found "); 
                  COMM_DBG.print(noOfDevices, 10); 
                  COMM_DBG.println(" temp sensors:");
                #endif
                devcnt=0;
                substate = 2;
              }
              // get adress and values of all sensors
              // wdu todo ds2438
              else if (substate == 2) {
                setDeviceAddress();
                temp_cmd = TEMP_CMD_NONE;
                tempstate = T_IDLE;
              }
             
              break;

    default:  tempstate = T_IDLE;
              break;
  }

}


void get_sensordata (unsigned int index, char *buffer, int buflen) {

  DynamicJsonDocument doc(1024);      // buffer size should be enough for about 22 sensors
  String testjson;
  String AddressStr;
 
  doc["cnt"] = noOfDevices;

  for (int i=0; i<(int)noOfDevices; i++)
  {     
    doc["sns"][i]["temp"] = tempsensors[i].temperature;

    AddressStr = "";
    for (uint8_t x = 0; x < 8; x++)
    {
      if (tempsensors[i].address[x] < 16) AddressStr += '0';
      AddressStr += String(tempsensors[i].address[x], HEX);
      if (x<7) AddressStr += ' ';
    }
    doc["sns"][i]["add"] = AddressStr;
  }

  serializeJson(doc, buffer, buflen);
}

void temp_command(int command) {
  
  if (command == TEMP_CMD_LOCK) {
    lock = 1;
  }
  else if (command == TEMP_CMD_UNLOCK) {
    lock = 0;
  }
  else if (temp_cmd == TEMP_CMD_NONE) temp_cmd = command;

}
