stefan-schweiger/VdMot_Controller/software_esp32/src/WT32AsyncOTA.cpp

/**HEADER*******************************************************************
  project : VdMot Controller

  author : SurfGargano, Lenti84

  Comments:

  Version :

  Modifcations :


***************************************************************************
*
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
  Copyright (C) 2021 Lenti84  https://github.com/Lenti84/VdMot_Controller

*END************************************************************************/
/*
    derived from  AsyncElegantOTA using WT32-ETH
    https://github.com/ayushsharma82/AsyncElegantOTA

*/

#include "Arduino.h"
#include "stdlib_noniso.h"

#if defined(ESP8266)
    #include "ESP8266WiFi.h"
    #include "ESPAsyncTCP.h"
    #include "flash_hal.h"
    #include "FS.h"
#elif defined(ESP32)
    #include "WiFi.h"
    #include "AsyncTCP.h"
    #include "Update.h"
    #include "esp_int_wdt.h"
    #include "esp_task_wdt.h"
    #include "Services.h"
#endif

#include "Hash.h"
#include <AsyncWebServer_WT32_ETH01.h>
#include "WT32AsyncOTA.h"
#include "Services.h"
#include "FS.h"



CWT32AsyncOTA WT32AsyncOTA;

CWT32AsyncOTA::CWT32AsyncOTA()
{
    _id = getID();
    _authorized = NULL;
    _uploadError = true;
}

void CWT32AsyncOTA::setID(const char* id)
{
    _id = id;
}

bool CWT32AsyncOTA::checkAuthorized(AsyncWebServerRequest *request)
{
    return ((_authorized == NULL) || _authorized(request));
}

void CWT32AsyncOTA::begin(AsyncWebServer *server, bool (*authorized)(AsyncWebServerRequest *request))
{
    _server = server;
    _authorized = authorized;
    _uploadError = true;        // set to false by the upload handler when an update has begun

    _server->on("/update/identity", HTTP_GET, [&](AsyncWebServerRequest *request){
        if (!checkAuthorized(request)) return request->requestAuthentication(NULL, false);
        #if defined(ESP8266)
            request->send(200, "application/json", "{\"id\": \""+_id+"\", \"hardware\": \"ESP8266\"}");
        #elif defined(ESP32)
            request->send(200, "application/json", "{\"id\": \""+_id+"\", \"hardware\": \"ESP32\"}");
        #endif
    });

    _server->on("/update", HTTP_GET, [&](AsyncWebServerRequest *request){
        if (!checkAuthorized(request)) return request->requestAuthentication(NULL, false);
        AsyncWebServerResponse *response = request->beginResponse_P(200, "text/html", WT32Upate_HTML, WT32Upate_HTML_SIZE);
        response->addHeader("Content-Encoding", "gzip");
        request->send(response);
    });

    _server->on("/update", HTTP_POST, [&](AsyncWebServerRequest *request) {
        // the request handler is triggered after the upload has finished, the upload handler sends no response
        if (!checkAuthorized(request)) return request->requestAuthentication(NULL, false);
        bool success = !_uploadError && !Update.hasError() && Update.isFinished();
        AsyncWebServerResponse *response = request->beginResponse(success?200:500, "text/plain", success?"OK":"FAIL");
        response->addHeader("Connection", "close");
        response->addHeader("Access-Control-Allow-Origin", "*");
        request->send(response);
        // only restart into a complete new firmware, a failed update keeps the running one
        if (success) restart();
    }, [&](AsyncWebServerRequest *request, String filename, size_t index, uint8_t *data, size_t len, bool final) {
        // upload handler, chunks in data
        // an unauthorized upload is ignored, the request handler answers with 401
        if (!checkAuthorized(request)) return;

        if (!index) {
            _uploadError = true;
            if (!request->hasParam("MD5", true)) return;
            if (!Update.setMD5(request->getParam("MD5", true)->value().c_str())) return;
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
