stefan-schweiger/VdMot_Controller/(commit log)

2026-10-18 STM32: make the build reproducible
    - pin the platform to ststm32@17.0.0 (Arduino core 2.6.0), the newest
    release in the registry that still builds; the unpinned latest
    (core 3.0) breaks the Serial2/Serial6 declarations
    - set SERIAL_TX/RX_BUFFER_SIZE=1024 as build flags instead of relying on
    a manually patched HardwareSerial.h in the core; the per-file defines
    in communication.cpp did not change the core buffers
    - add ${env.build_flags} to every env, the shared flags were never applied
    - use '/' in the OneWire include so it builds on macOS and Linux
    STM32_release_C2 builds to 53640 bytes (shipped 1.4.9: 53680 bytes).
    Claude-Ses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
2026-10-18 ESP32: make the build reproducible
    - pin the platform to espressif32@6.3.2 (Arduino core 2.0.9, ESP-IDF
    4.4.4, the IDF version the shipped 1.4.10 binary was built with)
    - add TaskManagerIO to lib_deps, it is now published as tcmenu/TaskManagerIO
    - pin ESP-Mail-Client to v3.1.10, the version that was current when it was
    added; PlatformIO never updates an installed git dependency
    - include <LittleFS.h> instead of <LITTLEFS.h> for case sensitive file systems
    The firmware compiles, but at 1.49 MB it does not fit into the 1.25 MB
    app partition, see the next commit.
    Claude-Session: https://claude.ai/code/session_01UuRbMdHp8NZ4v4jkthetXK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
    [ServerServices.cpp, VdmNet.cpp, VdmSystem.cpp, stm32.cpp]
2026-10-18 ESP32: build without email and Pushover notifications
    Email (ESP-Mail-Client) and Pushover (WiFiClientSecure/HTTPClient) are now
    optional and disabled by default, they can be enabled again with
    -DuseEmail / -DusePushover. Without them the firmware is 1.20 MB and fits
    into the 1.25 MB app partition again with ~110 KB to spare. The messenger
    settings stay in the config and web UI, nothing is sent.
    Notifications can be done by the home automation system via MQTT, which
    also avoids storing mail credentials on the device and the SMTP connection
    without certificate validation.
    Also include "PushOver.h" with its actual file name and drop the unused
    include from VdmNet.h.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
    [Messenger.cpp, Messenger.h, PushOver.cpp, PushOver.h, VdmNet.h]
2026-10-18 ESP32: validate config input from the web API
    - copy strings from json with a helper that always null terminates and
    ignores non string values; as<const char*>() returns NULL for numbers,
    which crashed strncpy (e.g. {"station":1234} on /sysconfig)
    - /tempsconfig: limit chunkStart/chunkEnd to the 34 sensor slots, larger
    values wrote behind tempsConfig
    - /voltsconfig: limit the number of entries to VOLT_SENSORS_COUNT
    - /valvesconfig: only accept tIdx1/tIdx2 in 0..34, they are used as array
    index into tempsConfig
    - /valvesctrlconfig: only accept link in 0..12; the "all valves" branch
    wrote every value except allow to valve 1 only (idx instead of i)
    - protConfig user/pwd used the size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
    [VdmConfig.cpp]
2026-10-18 ESP32: harden MQTT input and PI control
    MQTT
    - isFloat() rejects "nan" and "inf"; a single "nan" tValue (e.g. from
    ESPHome) made the PI integral NaN until reboot
    - isNumber("") is false, an empty valve segment selected valve 255
    - valve numbers in topics must be 1..12, the topic segment copy is bounded
    - target positions are limited to 0..100
    - valve names are copied with strlcpy, publish uses String::c_str()
    instead of the address of the String object
    - the tValue timeout only applies to valves that get tValue via MQTT;
    linked valves and valves with a DS18 value source never receive tValue
    and were set to failed after the timeout
    PI control
    - valveIndex is 255 until the PI services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
    [PIControl.cpp, PIControl.h, Services.cpp, helper.cpp, mqtt.cpp]
2026-10-18 ESP32: harden the STM32 link and STM32 update
    UART protocol
    - the receive buffer is bounded, more than 1199 bytes without line end
    overwrote the members behind buffer
    - empty lines no longer pass NULL to strncpy
    - leading \r/\n are skipped instead of reading one byte blindly after a
    line end, which could drop the first byte of the next answer
    - indices and counts in answers are checked against the array sizes
    - the gvlst/gonec/gowvc list parsers incremented idx twice, so only every
    second valve got a status and sensor ids landed in the wrong slots
    - the STM32 timeout counter is reset by every valid answer; before, any
    11 timeouts over the whole uptime hard reset the STM32
    - a target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
    [stm32.cpp, stm32.h, stmApp.cpp, stmApp.h]
2026-10-18 ESP32: small fixes in VdmSystem and VdmTask
    - getFSDirectory wrote Filenames[100] with 101 or more files
    - openFile passed a single char as mode string to open()
    - disOrEnableTask assigned instead of compared the task id (unused)
    Claude-Session: https://claude.ai/code/session_01UuRbMdHp8NZ4v4jkthetXK
    [VdmSystem.cpp, VdmTask.cpp]
2026-10-18 ESP32: add a cross platform generator for tfs_data.c
    web_pages_source/mktfs.py replaces zz.sh + mktfs.exe (Windows only). It
    gzips the files in web_pages_source/h and writes src/tfs_data.c in the
    same format. tfs_data.c is regenerated from the unchanged sources, the
    embedded files only differ in line endings (LF instead of CRLF).
    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
    [tfs_data.c]
2026-10-18 ESP32: enforce the login on the server
    The login only showed/hid tabs in the browser, every endpoint could be
    used without credentials, including the config posts, /cmd (reboot,
    restoreCfg, clearFS, fDelete), /setvalve, /fupload, /stmdoupdate and the
    ESP32 firmware update.
    When a user name and password are configured, these endpoints now require
    HTTP basic auth with them:
    - all json POST endpoints except /auth
    - /fupload (the upload is not written without auth)
    - /update (GET, POST) and /update/identity
    GET /msgconfig only contains the pushover tokens and the email password
    for authorized requests, the web ui loads it also without login.
    Status and config GET endpoints stay readable, as be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
    [ServerServices.cpp, WT32AsyncOTA.cpp, WT32AsyncOTA.h, tfs_data.c]
2026-10-18 ESP32: make the STM32 command queue thread safe
    Commands are pushed by the async web server and MQTT tasks and popped by
    the main loop, the linked list was not protected. pop() on an empty queue
    returns an empty string instead of dereferencing NULL, and the queue holds
    at most bufferSize entries (one more was accepted).
    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
2026-10-18 STM32: harden the command parser and validate commands
    Parser (ESP32 UART and debug terminal)
    - the receive buffer is bounded; the 990 byte limit was per call, more
    than 1000 bytes without line end wrote behind the static buffer
    - leading \r/\n are skipped; a \n at buffer[0] read buffer[c-1] with c=0
    and dropped the command that followed
    - cmd and arguments are zero initialized for every line
    Commands
    - stgtp: a target received during calibration was acknowledged but
    dropped (the ESP32 never sends it again), it is now kept and applied
    when the calibration has finished
    - smotc: startOnPower, noOfMinCounts and maxCalibRetries are checked with
    the same limits as on load from eeprom;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
    [app.cpp, communication.cpp, motor.h, otasupport.cpp, owDevices.cpp, terminal.cpp]
2026-10-18 STM32: fix stuck calibration and motor checks
    - learning: undercurrent and timeout during a learning run left
    calibration set, so new targets were ignored until the calibration
    timeout, which does not run for valves that are not connected or with
    learning movements 0. These paths now end the calibration like A_SET2.
    - learning: an unexpected M_RES_STOP (rev counter reached the target)
    was not handled and left the state machine in A_LEARNx forever, it is
    now handled as error
    - undercurrent has to be detected continuously, the counter was never
    reset during a stroke, so short dips over a long stroke reported an
    open circuit
    - motorcycle accepted valve number ACTUATOR_COUNT (> ins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
    [main.cpp, motor.cpp]
2026-10-18 Fix issues found in review of the previous commits
    ESP32
    - unauthorized api calls get a plain 401 without WWW-Authenticate, the
    ui calls /cmd getFS on every page load and the browser showed its login
    dialog to anonymous viewers; only the /update pages ask the browser
    - the ui updates its stored credentials after posting changed user name
    or password; the server uses them immediately, so all following posts
    of "save config" including saveCfg failed with the old credentials
    - a DS18 failure/recovery only affects valves that use exactly this
    sensor as value source; a healthy second sensor of the valve released
    the failed state every minute
    - the target ack is matched against valve a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
    [ServerServices.cpp, Services.cpp, communication.cpp, motor.cpp, owDevices.cpp, stmApp.cpp, tfs_data.c]
2026-10-18 ESP32: add a per valve minimum opening
    Some valves make flow noise when they are opened only a little. With a
    minimum opening m (Control page, column "Min. open(%)", 0 = off) targets
    between 1 and m-1 are not sent to the STM32:
    - an open valve stays at m until the target drops below m/2, then closes
    - a closed valve stays closed until the target reaches m
    Targets of 0 and from m upwards are sent unchanged.
    It is applied where the targets are sent to the STM32, so it covers all
    sources (pi control, linked valves, mqtt/json targets, window, park and
    timeout positions). The setting is stored with its own nvs key, the
    existing valve control blobs keep their layout and the default is off.
    The c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
    [VdmConfig.cpp, VdmConfig.h, stmApp.cpp, stmApp.h, tfs_data.c, web.cpp]
2026-10-21 Add a 3D printable case (draft)
    Parametric FreeCAD script generating a base and a lid for the board from
    the C3 3D model, plus a fit check frame. The board rests on posts and is
    held by pins of the lid at spots that are free of components and through
    hole pins, the openings for all connectors are open at the bottom of the
    lid, so both parts print without supports. Checked against the board
    model for collisions, not printed yet.
    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
    [vdmot_case.step, vdmot_case_base.stl, vdmot_case_fitcheck.stl, vdmot_case_lid.stl]
2026-10-21 Case: more clearance for posts, clamps and solder joints
    - posts and clamp pins on the same 10 spots, the board is clamped between
    them; posts keep >= 1.9 mm to through hole pins and parts below the
    board, clamps >= 1.4 mm to components (was 0.5 mm at some spots)
    - 5 mm between floor and board (was 4 mm), 3.1 mm below the longest pins
    of the 3D model
    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
    [vdmot_case.step, vdmot_case_base.stl, vdmot_case_lid.stl]
2026-10-22 Case: room for the latches of the terminal plugs
    The screw plugs of X13 (power) and X18 (1-wire) stay outside the case,
    but their latches reach into it above the header, the lid wall blocked
    them. The openings of the pluggable terminals now go up to 15 mm above
    the board (PLUG_OPENING_TOP). Only the lid and the fit check frame change.
    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
    [vdmot_case.step, vdmot_case_fitcheck.stl, vdmot_case_lid.stl]
2026-10-22 Case: plug latch openings only 2 mm higher than the header
    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
    [vdmot_case.step, vdmot_case_fitcheck.stl, vdmot_case_lid.stl]
2026-10-22 Case: heat set inserts for the lid screws
    The base posts now have 4.0 mm holes with a 0.5 mm chamfer for M3 heat
    set inserts of 4 mm length (e.g. ruthex M3 short), 7.1 mm deep, 2.25 mm
    wall. Lid screws M3 x 8 socket head. Self tapping screws still possible
    with SCREW_PILOT_D = 2.6. Only the base changes.
    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
    [vdmot_case.step, vdmot_case_base.stl]
2026-10-22 Case: remove the clamp pin in the vent area
    The pin at (137.75, 43.25) interrupted the roof vents and touched a
    component on a real board. 9 clamp pins remain, the post below stays.
    Only the lid changes.
    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
    [vdmot_case.step, vdmot_case_lid.stl]
2026-10-22 Case: 4 clamp pins with a gap instead of 9 pressing ones
    The connectors along the front and back edge already keep the board from
    lifting more than the opening clearance. The lid keeps 4 pins at the
    middle and the short edges, 0.75 mm above the board. Only the lid changes.
    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
    [vdmot_case.step, vdmot_case_lid.stl]
2026-10-22 Case: screw the board down through two mounting holes
    Two screw posts with heat set inserts in the base at the mounting holes
    measured on a real board (between the power terminal and X12, and below
    the WT32 module), M3 x 6. The support post next to the first hole is
    dropped, the lid has no pins on the board anymore. Checked against the
    board model including the screw heads.
    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
    [vdmot_case.step, vdmot_case_base.stl, vdmot_case_lid.stl]
2026-10-22 Case: smaller and with rounded corners for 180 mm beds
    - walls 2.0 mm, side margins 7.5 mm, lid bosses and base posts 7.6 mm
    (6.0 mm counterbore for DIN 912 heads, 1.8 mm wall around the inserts)
    - 5 mm radius on the vertical outer corners against lifting corners
    - wall mounting holes 4.0 mm for screws up to 3.5 mm
    Outer size 175.4 x 90.8 x 37.6 mm, fits a 180 x 180 mm bed with room for
    a small brim. Base and lid change.
    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
    [vdmot_case.step, vdmot_case_base.stl, vdmot_case_fitcheck.stl, vdmot_case_lid.stl]
2026-10-22 Case: stronger fingers between the valve jack openings
    Wall thickness per side: front 3.0 mm (the fingers between the jack
    openings broke easily), back 2.2 mm (the terminal plugs have to reach
    their headers), left/right 2.0 mm (length of the case). The top corners
    of the jack openings are rounded (1 mm) against cracks at the finger
    roots. Outer size 175.4 x 92.0 x 37.6 mm.
    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
    [vdmot_case.step, vdmot_case_base.stl, vdmot_case_fitcheck.stl, vdmot_case_lid.stl]
2026-10-22 Web UI: new layout with Tailwind CSS
    - light card layout with a tab bar, the Network tab is merged into the overview
    - settings grouped (general, connectivity, valves, sensors, maintenance)
    with a sticky save bar
    - soft status colors with a legend instead of full red/yellow/green cells
    - help popups on the columns of the valve control table
    - Pushover/email settings only shown if compiled into the firmware
    (new fields msgPushover/msgEmail in /sysinfo)
    - login dialog no longer puts user and password into the URL
    - css generated by web_pages_source/tailwind/build.py (Tailwind 3.4.17),
    all element ids used by the script are unchanged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
    [tfs_data.c, web.cpp]
2026-10-22 STM32: start a requested calibration right away
    Learning runs only started after the first target change since the
    start, but targets are held back while a calibration is pending. A
    calibration requested before any target change (e.g. right after a
    restart) therefore never started. A calibration request now allows the
    learning runs immediately.
    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
2026-10-23 ESP32: add a per valve maximum opening for hydraulic balancing
    The manifold has no adjustable flow meters, so the actuators have to limit
    the flow. Every target sent to the STM32 is scaled to 0..maximum opening:
    100 % of the controller, the copied position of a linked valve and targets
    set by hand or MQTT. The minimum opening works on the scaled value.
    - stored with its own nvs key (valvesCtrl3), default 100 = off
    - /valvesctrlconfig: new field maxOpen (1..100)
    - web ui: column "Max. open(%)" with help text, narrower number inputs so
    the 18 columns still fit
    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
2026-10-23 ESP32: publish the actual valve position via MQTT
    valves/<name>/position is the position reported by the STM32. With a
    maximum opening it differs from the target. The change check of the
    valves already compared this value but it was never stored, so every
    valve was republished after the minimum delay instead of on change.
    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
2026-10-23 ESP32: replace minimum and maximum opening by a valve range
    Every target of a valve (controller incl. active zone, linked valve,
    manual, MQTT, park position) is mapped to its range: 1..100 % become
    from..to, 0 % closes the valve or, without "can close", keeps it at
    "from". "to" limits the flow of the loop for hydraulic balancing,
    "from" avoids small openings with flow noise or keeps a minimum flow.
    The stored minimum opening (valvesCtrl2) becomes "from" and the maximum
    opening (valvesCtrl3) "to", "can close" is new (valvesCtrl4, default
    on), so existing settings keep their meaning. JSON fields rangeFrom,
    rangeTo and rangeClose replace minOpen and maxOpen, the web UI shows
    one "Valve range"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
    [VdmConfig.cpp, VdmConfig.h, stmApp.cpp, tfs_data.c, web.cpp]
2026-10-23 ESP32: run the web commands on the main loop
    The /cmd actions (saving the settings and the control settings,
    calibration, assembly, valve and sensor scan, MQTT reconnect, syslog,
    file actions, HA discovery) and the STM32 update ran in the task of
    the web server. They write the NVS, stop and start the PI tasks, push
    commands for the STM32 and use the MQTT client of the main loop at the
    same time, and that task is reset by the task watchdog when a request
    takes 5 s, a suspect for the TASK_WDT restart. They are queued now and
    run on the main loop in the order of the requests, the answer is sent
    right away.
    The time on the status page no longer waits for a time sync: while the
    clock was not set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
    [ServerServices.cpp, VdmSystem.cpp]
2026-10-23 ESP32: save the settings without a restart
    Every save of the Settings page restarted the controller, and with it
    the STM32, so all valves learned their stroke again for minutes. Now
    only changed network settings (interface, DHCP, addresses, Wi-Fi)
    restart, compared with the settings the network was started with.
    Everything else is applied right away: most settings are read where
    they are used, a changed time server or time zone sets up SNTP again,
    changed syslog settings restart the syslog client, and changed MQTT
    settings, station name or valve names connect to the broker again, so
    the topics and subscriptions are built anew. The station name is used
    as host name from the next start.
    saveC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
    [ServerServices.cpp, VdmConfig.cpp, VdmConfig.h, VdmNet.cpp, VdmNet.h, VdmTask.cpp, VdmTask.h, tfs_data.c]
2026-10-23 ESP32: keep the STM32 running on a restart for new settings or an update
    Every start of the ESP32 except power on reset the STM32, so after a
    restart all valves were tested and learned their stroke again (the
    learned values are only in the RAM of the STM32) and moved to the
    position at power on until the controller set them again.
    A restart for changed network settings and the restart after an ESP32
    update now keep the STM32 running: the restart leaves a flag in the RTC
    RAM, and only a software restart with this flag skips the reset. At
    the start the ESP32 reads the targets of the STM32 (gtgtp), takes them
    as its targets (mapped back through the valve range) and as already
    sent, and does no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
    [RtcRam.cpp, RtcRam.h, Services.cpp, Services.h, VdmConfig.cpp, WT32AsyncOTA.cpp, main.cpp, stmApp.cpp]
2026-10-23 ESP32: show the sensors on the 1-wire bus with their temperature
    The ESP32 reads the temperature of every sensor on the bus but kept it
    only for the sensors in the settings. It keeps the last reading of each
    sensor now, /tempsensorsid answers with "temp" (null while there is no
    reading or the sensor failed).
    The temperature sensor card of the Settings page lists the sensors on
    the bus with their temperature, refreshed every 2 s, and the row of the
    settings they are in, so a sensor warmed in the hand is easy to find.
    "Use" puts the ID of a sensor not in the settings into the next free
    row. The ID selects are only rebuilt when the sensors change, so the
    refresh does not close an open select.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
    [stmApp.cpp, stmApp.h, tfs_data.c, web.cpp]
2026-10-30 ESP32: show how the target of a valve becomes its opening
    The valve range maps every target to an opening, but the Status page
    shows the opening and the target next to each other without saying
    how they relate (target 20 of Bad with the range 20-70 is an opening
    of 30 %).
    An "i" next to the opening on the Status page and next to the range
    on the Control page opens a popup with a drawing: the target bar on
    top, the valve stroke below with the range, the band between them
    shows where each target ends up, a line from the current target to
    its opening and a mark at the actual opening. Below it the
    calculation (20 + 50 x 20 % = 30 %), the actual opening, what target
    0 does and the openings for 1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
2026-10-30 ESP32: show the reason of the last restart and where it crashed
    After a restart the ESP32 publishes "reset system by :<reason>" via
    MQTT, but the web page did not show the reason and after a crash
    (PANIC, watchdogs) nothing told where it happened: there is no core
    dump partition and the backtrace only goes to the serial port.
    The panic handler of ESP-IDF is wrapped (-Wl,--wrap=esp_panic_handler,
    PanicRecord.cpp). Before the normal handling the wrapper stores the
    exception, the crash address, the accessed address and up to 8
    backtrace addresses in RTC memory, which keeps its content over the
    restart. It runs from IRAM, reads no strings and only calls the stack
    walk ESP-IDF uses for its own b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
    [PanicRecord.cpp, PanicRecord.h, VdmSystem.cpp, VdmSystem.h, main.cpp, tfs_data.c, web.cpp]
2026-10-31 ESP32: keep the RTC memory layout over updates
    An update hands keepStmRunning (keep the STM32 running over the
    restart) and the states of the controllers over in RTC memory. As
    separate variables the linker placed them in an order of its own: the
    panic record of 929c3b7 went first and moved the others, so the update
    to it reset the STM32 and the controllers lost their state.
    All variables in RTC memory are now members of one struct (RTC_RAM) in
    the order of 929c3b7: panic record at 0x50000200, keepStmRunning
    0x50000238, piControlRtcs 0x5000023c, readingCnt 0x500003ec, with
    static_asserts on the offsets. New members only go at the end. The old
    names stay as references to the members.
    Co-Aut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
    [PanicRecord.cpp, RtcRam.cpp, RtcRam.h]
2026-10-31 ESP32: controller settings for all zones, direct valve range, no active zone
    The Control tab had 18 columns per valve, most of them controller
    settings that are the same in every zone.
    Settings for all zones: the controller settings (room and set
    temperature source, set temperature after a restart, Xp, Ti, window
    contact, regulates in, Ts, deadband, offset, scheme, ki) are stored once
    for all zones (nvs valvesCtrl5) and per valve which of them the zone
    sets itself (valvesCtrl6). After loading and after every post the
    values a zone does not set itself are copied from the settings for all
    zones, so the controller keeps reading the per valve values. Settings
    that were never saved are worked ou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
2026-10-31 ESP32: keep the valve while the window is open, wait after closing
    With a window contact the valve went to the window target (normally
    closed) and the controller paused until the window closed, then it
    continued at once. On floor heating closing the valve during airing
    saves almost nothing, the slab keeps its warmth, and the controller
    then sees the air that is still cold: with a small Xp it opens the
    valve wide and the room overshoots hours later.
    Two more controller settings, for all zones or per zone like the
    others (nvs valvesCtrl8, json windowMode and windowHold):
    - window open: close the valve (to .../window/target, as before) or
    keep the valve where the controller had it. In both c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
    [PIControl.cpp, PIControl.h, VdmConfig.cpp, VdmConfig.h, tfs_data.c, web.cpp]
2026-10-31 ESP32: keep the state of a direct valve range over a restart
    With a direct valve range and "can close" a valve keeps its state for
    targets between from - 5 % and from. After a restart of the ESP32 that
    state started as open, so a closed valve with its target in the band
    opened to "from" (Schlafen 0 -> 10 % with a target of 7 %). The state
    is now taken from the target the kept STM32 reports: above 0 is open.
    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
2026-10-31 ESP32: names of valves and sensors with up to 30 characters
    Valve, temperature and voltage sensor names were limited to 10
    characters ("RL Wohnen2"), only because they are fixed fields of the
    settings blobs in nvs.
    The names now have 30 characters (NAME_LEN). The blobs with the new
    layout are stored with their own keys (valves2, temps2, volts2). At the
    start without them the blobs of the old layout are taken over, and they
    are still written with names cut to 10 characters, so an older firmware
    finds its settings. The name buffers for the MQTT topics are larger,
    the name fields of the web page take 30 characters.
    A name is part of the MQTT topics of its valve or sensor, renaming one
    gives i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
    [VdmConfig.cpp, VdmConfig.h, mqtt.cpp, tfs_data.c]
